MikkelBlom/SENNEP-V2/print/chassis_v1/LÆS MIG.md

# Chassis v1 — minimum rullende stel

4 housings (hjørnerne) + det her = et stel, der kan samles og rulle. Kofangere, ydre tværbjælker, LiDAR-mast og batteriplade kommer senere.
Alle filer er vendt rigtigt (printfladen på Z = 0). **Ingen support.**

| Fil | Antal | Ligger på pladen med | Mål |
|---|---|---|---|
| 4x_Rail.stl | 4 | Toppen (den lukkede side) nedad | 60 × 219 × 50 mm |
| 4x_Cross_half.stl | 4 | Toppen nedad | 199 × 34 × 40 mm |
| 4x_Key_bar.stl | 4 | En flad side | 30 × 4,2 × 4,2 mm |
| 20x_P-M8x22_bolt.stl | 20 | En af de to flade sider (liggende) | M8, du skærer gevind med snitbakke |
| 20x_P-M8_nut.stl | 20 | Flangen nedad | Ø7-hul, du tapper M8 |

**Universelle dele:** samme skinne til alle fire pladser og samme halve tværbjælke til alle (vend/drej den bare). Midtersamlingerne har en V-rille i begge dele + en løs nøglestang. Bolte og møtrikker har en indbygget flange, så der er ingen skiver.

## Indkøbt hardware
16× M3×12 + 16 M3-messingindsatser (skinnerne ind i housingernes sideflader, 4 pr. skinne).

## Samling
1. Smelt indsatserne ned i housingernes **indre** sideflader (dem, der vender mod robottens midte), 4 pr. housing.
2. Skinner på housingerne: V-ryggen i housingens rille, 4× M3×12 pr. skinne.
3. Skinnernes midtersamling: nøglestang i rillen, 4× P-M8 pr. side.
4. Tværbjælker (de to inderste, y = ±60): hver halvdel sættes i skinnens indervæg (V-ryg i rille, 2× P-M8), de to halvdele samles i midten med en nøglestang og 2× P-M8.
   Skinnerne har riller og huller i begge vægge, så samme del passer i alle hjørner — dem i ydervæggen bruges ikke.
