MikkelBlom/SENNEP-V2/docs/skelet/body_v0_front.png

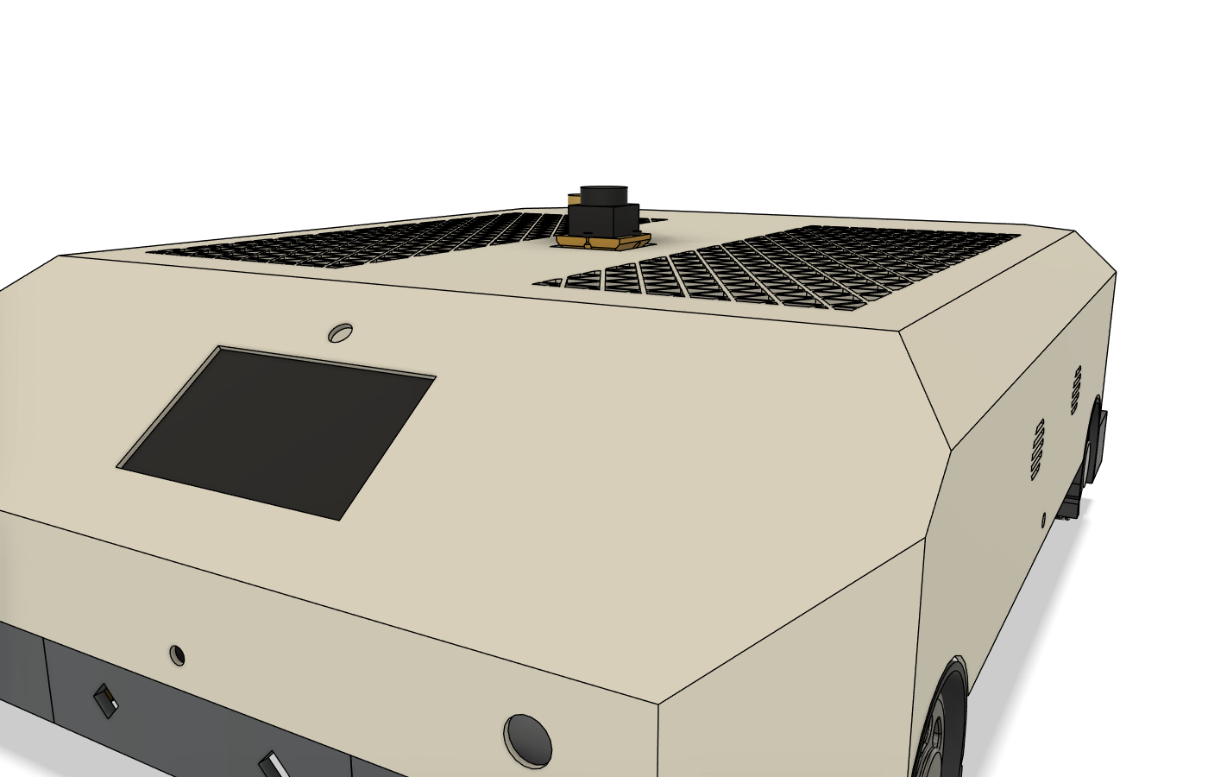
docs/skelet/body_v0_front.png
