MikkelBlom/SENNEP-V2/docs/skelet/body_v0_skraat.png

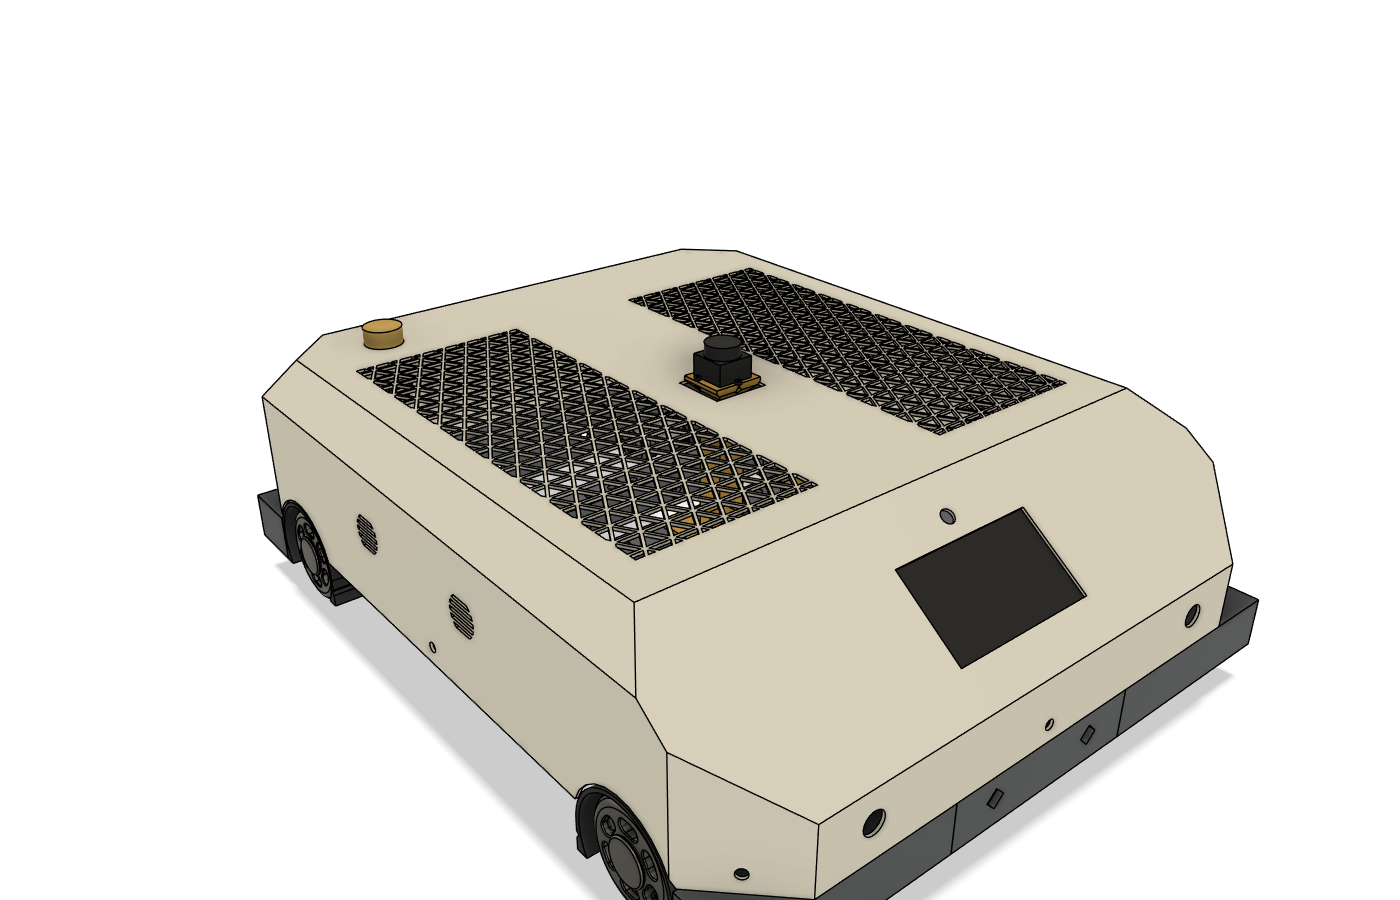
docs/skelet/body_v0_skraat.png
