MikkelBlom/SENNEP-V2/docs/skelet/pod_gennemsigtig.png

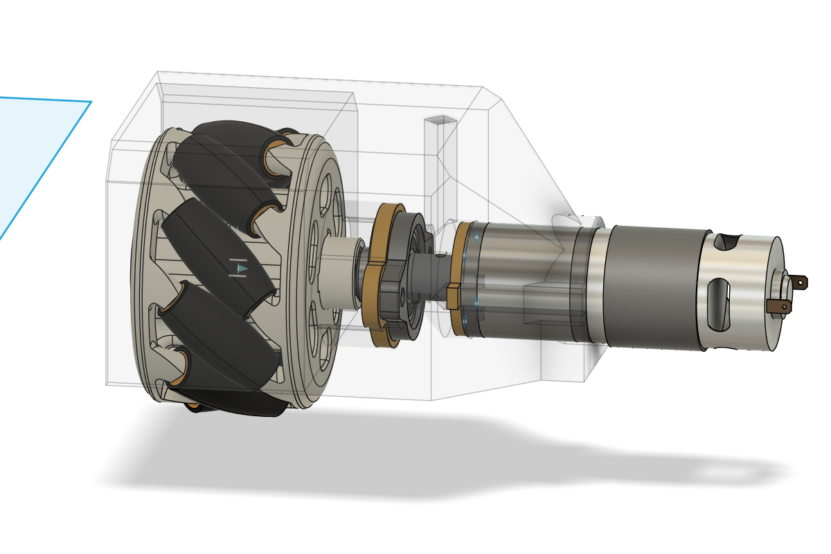
docs/skelet/pod_gennemsigtig.png
