MikkelBlom/SENNEP-V2/docs/skelet/pod_hjulside.png

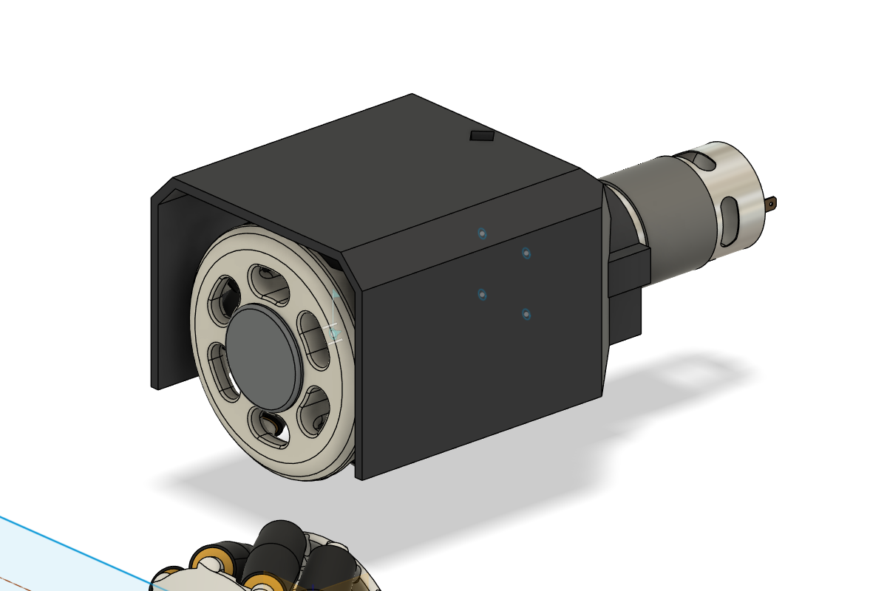
docs/skelet/pod_hjulside.png
