MikkelBlom/SENNEP-V2/docs/skelet/v1_skelet_iso.png

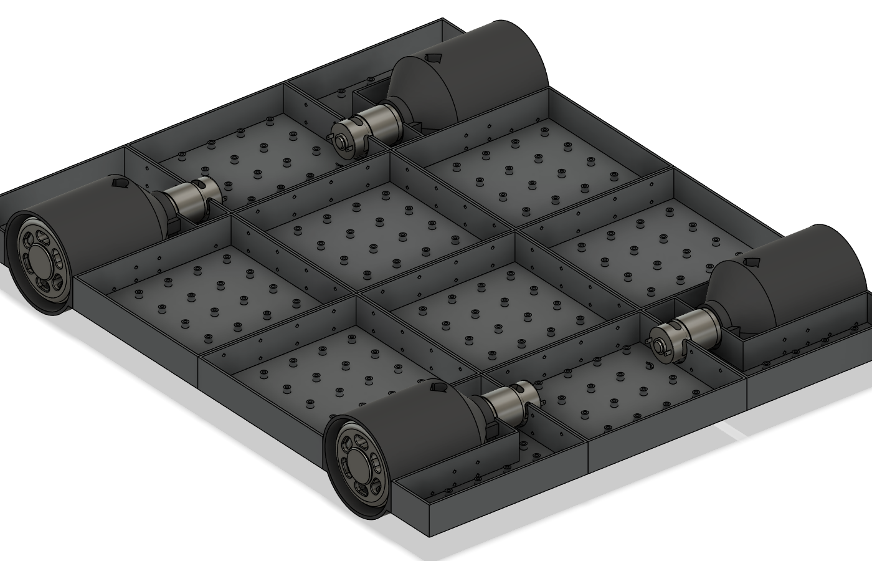
docs/skelet/v1_skelet_iso.png
