MikkelBlom/SENNEP-V2/docs/skelet/v1_skelet_top.png

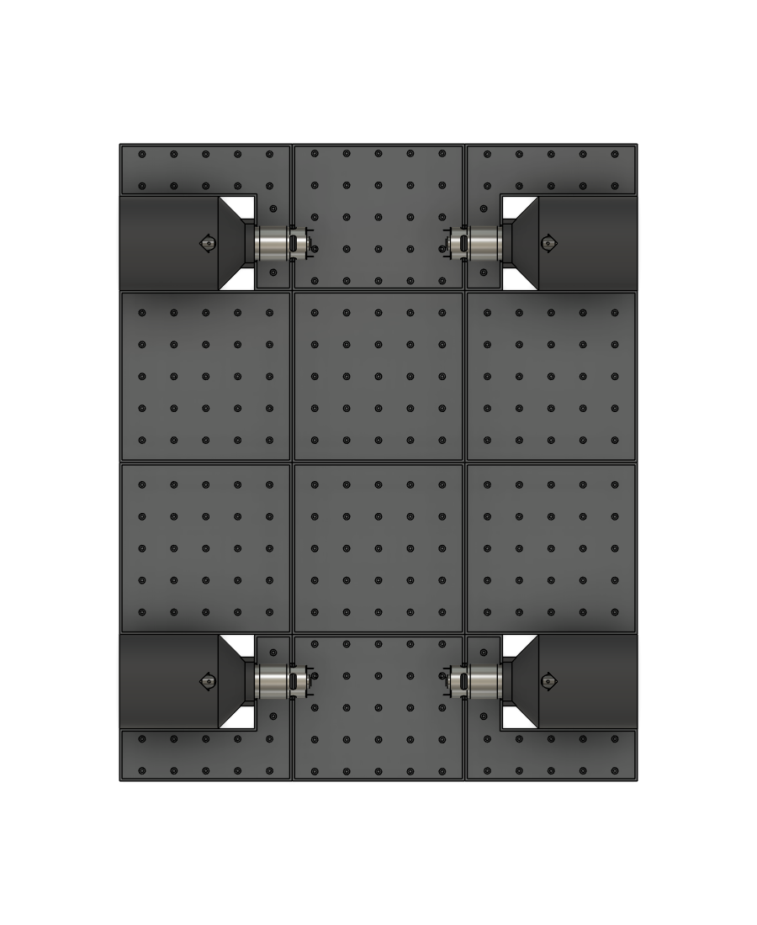
docs/skelet/v1_skelet_top.png
