MikkelBlom/SENNEP-V2/docs/skelet/v2_batteri.png

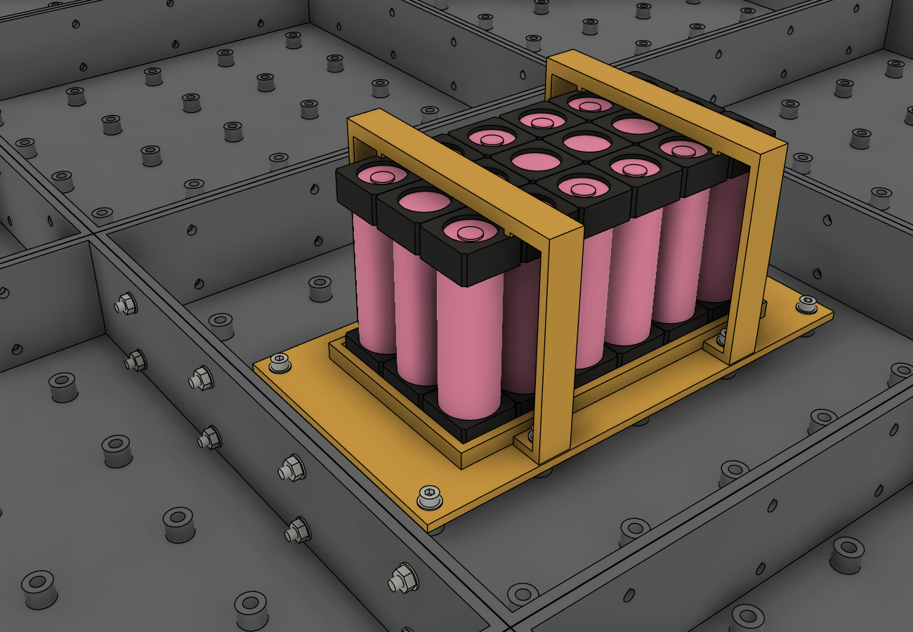
docs/skelet/v2_batteri.png
