MikkelBlom/SENNEP-V2/docs/skelet/v2_hjul_mod_gulv.png

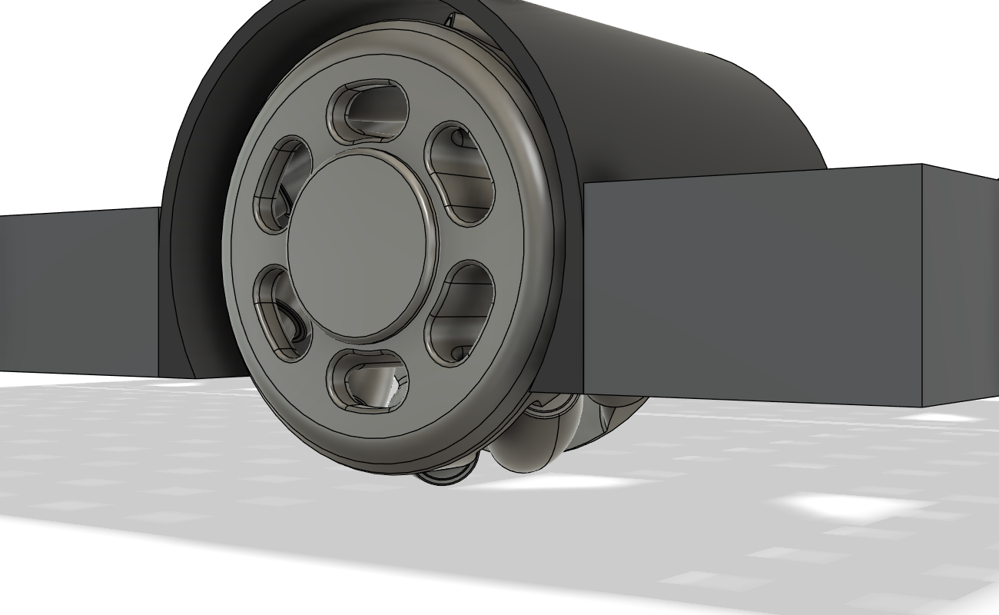
docs/skelet/v2_hjul_mod_gulv.png
