MikkelBlom/SENNEP-V2/docs/skelet/v3_diamantkanal.png

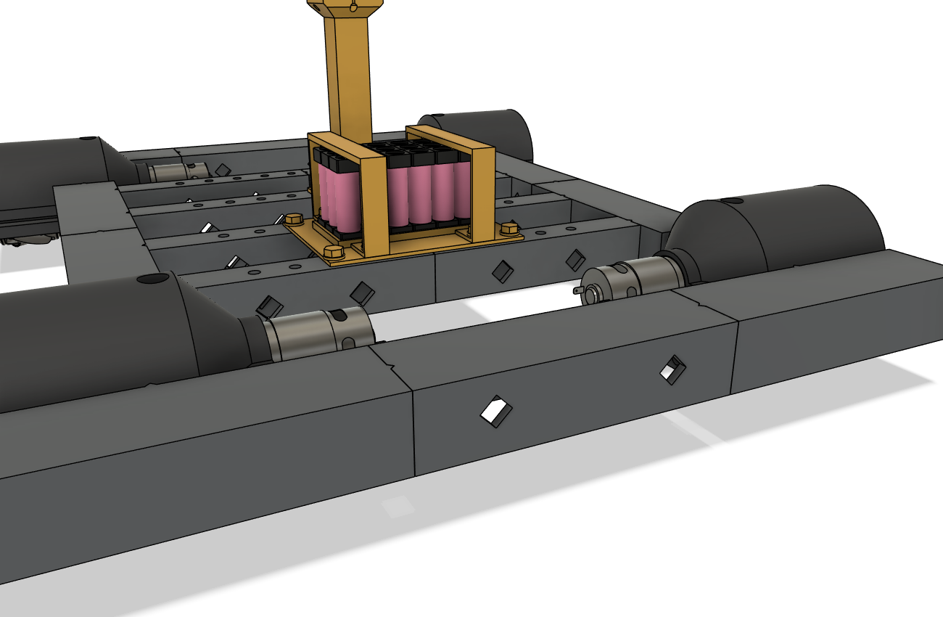
docs/skelet/v3_diamantkanal.png
