MikkelBlom/SENNEP-V2/docs/skelet/v3_kofanger_kvadrathul.png

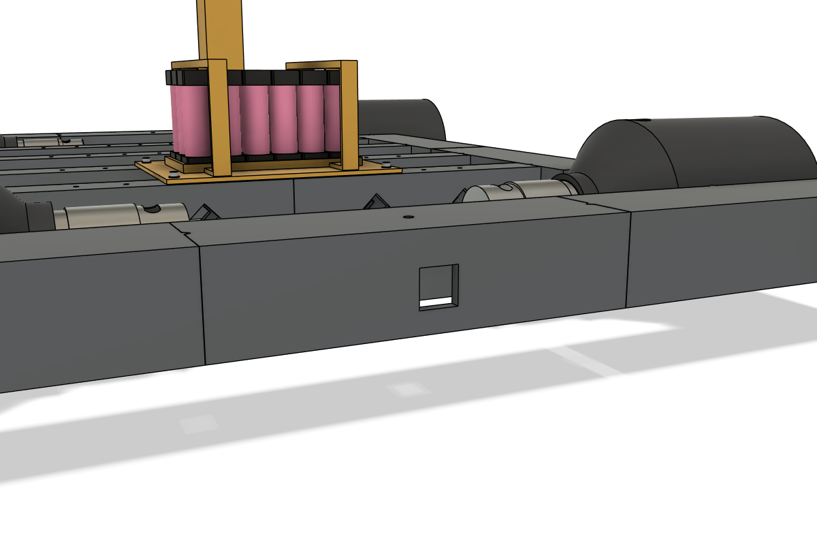
docs/skelet/v3_kofanger_kvadrathul.png
