MikkelBlom/SENNEP-V2/docs/skelet/v3_samling_nedefra.png

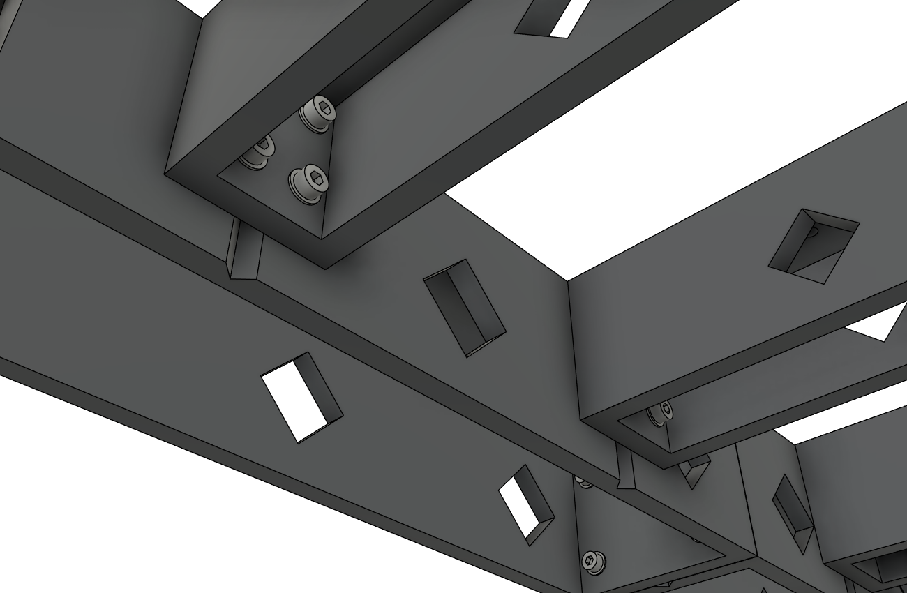
docs/skelet/v3_samling_nedefra.png
