MikkelBlom/SENNEP-V2/print/testhjul_v3.1/hjulkasse/samling_1_hardware.png

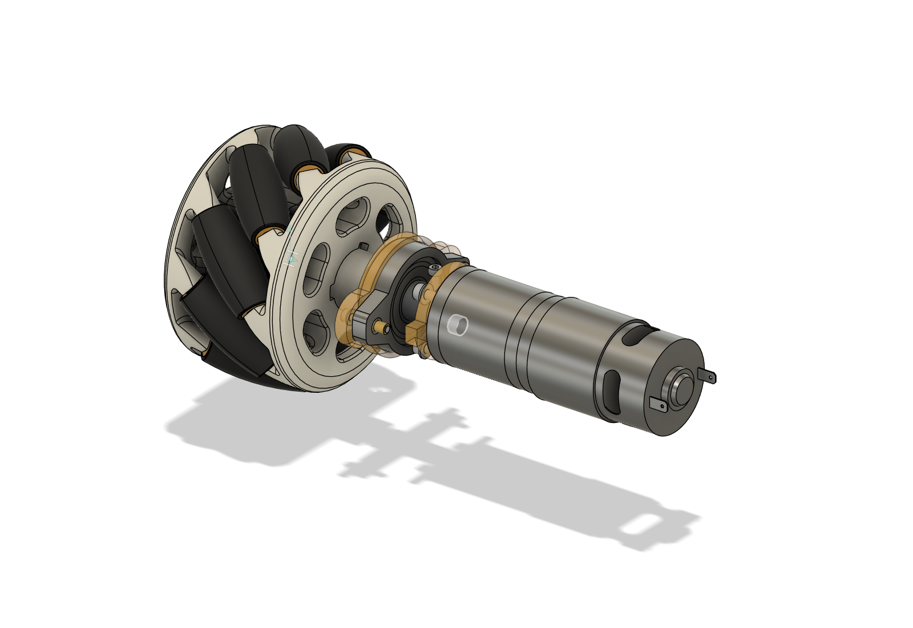
print/testhjul_v3.1/hjulkasse/samling_1_hardware.png
