MikkelBlom/SENNEP-V2/print/testhjul_v3.1/hjulkasse/samling_2_hardware_uden_hjul.png

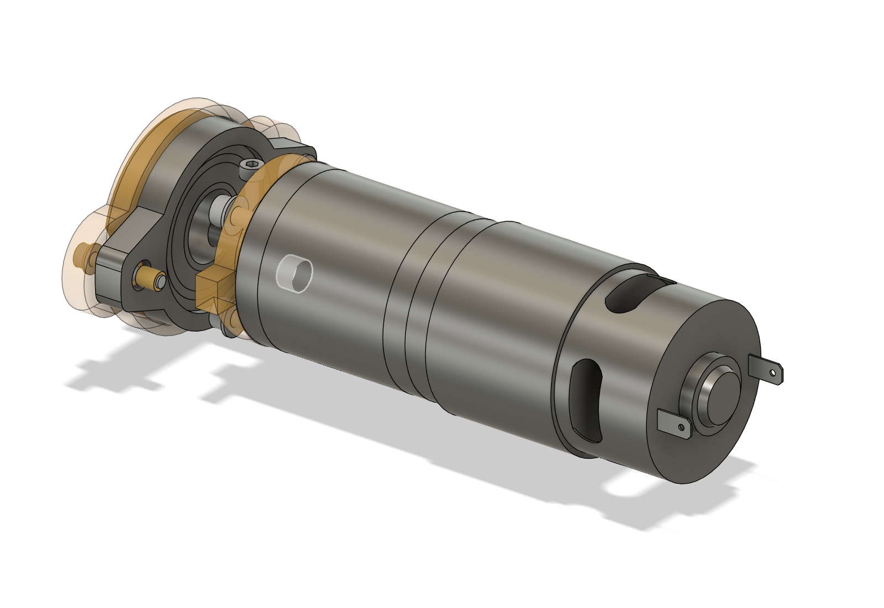
print/testhjul_v3.1/hjulkasse/samling_2_hardware_uden_hjul.png
