MikkelBlom/SENNEP-V2/components/INVENTORY.md

# Parts list — SENNEP V2

> Generated by `build_inventory.py` from `inventory.csv`. Edit the CSV, not this file.

100 lines · [Compute](#compute) · [Drivetrain](#drivetrain) · [Power](#power) · [Sensors](#sensors) · [Communication](#communication) · [UI](#ui) · [Sound](#sound) · [Lighting](#lighting) · [Control](#control) · [Connectors](#connectors) · [Cables](#cables) · [Passives](#passives) · [Mechanical](#mechanical) · [Hardware](#hardware) · [Consumables](#consumables) · [Tools](#tools)

## By source

| Source | Lines |
|---|---:|
| SENNEP V2 | 86 |
| SENNEP V1 | 3 |
| other project | 11 |

## By store (excl. shipping)

| Store | ≈ DKK |
|---|---:|
| Ardustore | 2,003 kr |
| Hobby Components | 824 kr |
| Bot'n Roll | 2,693 kr |
| AliExpress | 883 kr |
| RS / school (V1) | 2,400 kr |

## Compute

| id | Part | Qty | Source | Condition | ≈ DKK | Store | Date | Datasheet / links | Notes |
|---|---|---:|---|---|---:|---|---|---|---|
| `arduino-mega` | Arduino Mega 2560 R3 (clone) | 2 | SENNEP V2 | unknown | 490 kr | Ardustore | 2024-05-14 | [arduino-mega-2560.pdf](datasheets/arduino-mega-2560.pdf) | Main MCU for the Pi link (Nano also used) |
| `arduino-nano` | Arduino Nano clone, CH340, USB-C | 2 | SENNEP V2 | unknown | 65 kr | Hobby Components | 2025-04-18 | [arduino-nano.pdf](datasheets/arduino-nano.pdf) · [ch340.pdf](datasheets/ch340.pdf) | Low-level jobs alongside the Mega. Needs the CH340 driver on Windows |
| `nano-terminal` | Screw-terminal adapter for Arduino Nano | 2 | SENNEP V2 | unknown | 27 kr | Hobby Components | 2025-04-18 |  |  |
| `raspberry-pi-5` | Raspberry Pi 5 | 1 | SENNEP V2 | unknown | ? | unknown | 2025-05 | [raspberry-pi-5.pdf](datasheets/raspberry-pi-5.pdf) | No receipt. RAM 4 or 8 GB per Mikkel (unconfirmed: check the sticker or run free -h). At Mikkel's parents (Oct 2026) |
| `pi5-case` | Aluminium case for Pi 5 with 2 fans (Waveshare 26086) | 1 | SENNEP V2 | unknown | 70 kr | Bot'n Roll | 2025-05-01 |  |  |
| `sd-32gb` | microSDHC 32 GB Adata Class 10 | 1 | SENNEP V2 | unknown | 34 kr | Bot'n Roll | 2025-05-01 |  | Pi OS installed May 2025 (user sennep) |
| `sd-16gb` | SD card 16 GB Class 10 + adapter | 1 | SENNEP V2 | unknown | 50 kr | Ardustore | 2024-05-14 |  |  |

## Drivetrain

| id | Part | Qty | Source | Condition | ≈ DKK | Store | Date | Datasheet / links | Notes |
|---|---|---:|---|---|---:|---|---|---|---|
| `l298n` | L298N dual H-bridge module | 2 | SENNEP V2 | unknown | 80 kr | Ardustore | 2024-05-14 | [l298n.pdf](datasheets/l298n.pdf) | Max ~2 A/channel and ~2 V drop. To be replaced by h-bridge-43a |
| `h-bridge-43a` | High-power H-bridge motor driver (probably BTS7960, 43 A) | 5 | SENNEP V2 | unknown | 182 kr | AliExpress | 2025-12 | [bts7960.pdf](datasheets/bts7960.pdf) | Item name truncated in the order mail, so the chip is not confirmed. 4 in use + 1 spare |
| `motor-rs834` | RS PRO 834-7641 gear motor 12 V, 49:1 (975D series) | 4 | SENNEP V1 | unknown | 2,400 kr | RS / school (V1) | 2020-2023 | [rs-pro-834-7641-motor.pdf](datasheets/rs-pro-834-7641-motor.pdf) | Approximate price for all 4. 8 mm shaft, 143 rpm, 41 W. Radial load < 5 kgf -> pillow blocks carry the weight |

## Power

| id | Part | Qty | Source | Condition | ≈ DKK | Store | Date | Datasheet / links | Notes |
|---|---|---:|---|---|---:|---|---|---|---|
| `18650-35e` | Samsung INR18650-35E Li-ion 3400 mAh | 20 | SENNEP V2 | unknown | 880 kr | Bot'n Roll | 2025-05-01 | [samsung-inr18650-35e.pdf](datasheets/samsung-inr18650-35e.pdf) | Planned 3S6P (10.8 V nom / 12.6 V full, ~20 Ah). Only clicked into holders, no connections at all (Oct 2026). Plan: docs/electronics/BATTERY_PLAN.md |
| `18650-holder` | 18650 holder 1×2 with spacer | 20 | SENNEP V2 | unknown | 45 kr | Bot'n Roll | 2025-05-01 |  | Click-together plastic, no metal contacts |
| `nickel-strip` | Pure nickel strip 0.15 mm for integrated 18650 holders, 1P + 2P (2P = ladder ~27 mm wide), 19 mm spacing | 1 | SENNEP V2 | unknown | ? | AliExpress | 2025-05 |  | Rolls, length unknown. 2P = two rails joined by rungs, meant to span two rows (strips A and D), 1P for B and C. Strip pitch 19 mm vs holder pitch (to measure). See docs/electronics/BATTERY_PLAN.md §4 |
| `bms-3s` | 3S 40 A BMS with balancing (HW-288 per product photo) | 2 | SENNEP V2 | unknown | 73 kr | Bot'n Roll | 2025-05-01 | [web](https://www.botnroll.com/en/bms/4974-li-ion-18650-bms-charger-pcb-prot-board-3s-11-1v-12-6v-40a-with-balance.html) | Listing: 40 A continuous (less without cooling), start current < 80 A, charge 12.6–13.6 V up to 10 A, auto recovery, 60 × 41 × 3.4 mm. Taps 0 / 4.2 / 8.4 / 12.6 V = B− / B1 / B2 / B+. Mikkel thinks 2 or 3 bought |
| `charger-3s` | 3S Li-ion charger 12.6 V 2 A (EU plug) | 1 | SENNEP V2 | unknown | 89 kr | Bot'n Roll | 2025-05-01 |  |  |
| `buck-5a` | DC-DC step-down 5 A | 2 | SENNEP V2 | unknown | 61 kr | Hobby Components | 2025-04-18 |  | Meant for the Pi 5 (5 V / 5 A) |
| `lm2596-module` | LM2596 step-down module with voltmeter | 3 | SENNEP V2 | unknown | 58 kr | Hobby Components | 2025-04-18 | [lm2596.pdf](datasheets/lm2596.pdf) | Max 3 A |
| `lm2596t-12` | LM2596T-12 regulator (TO-220, fixed 12 V) | 3 | SENNEP V2 | unknown | 24 kr | Ardustore | 2024-05-14 | [lm2596.pdf](datasheets/lm2596.pdf) |  |
| `l7805` | L7805 5 V linear regulator (TO-220) | 10 | SENNEP V2 | unknown | 20 kr | Ardustore | 2024-05-14 | [l7805.pdf](datasheets/l7805.pdf) | The datasheet is TI's µA7800 (same pinout/function as ST L7805) |
| `ld1117-33` | LD1117V33 3.3 V linear regulator (TO-220) | 3 | SENNEP V2 | unknown | 24 kr | Ardustore | 2024-05-14 | [ld1117-3v3.pdf](datasheets/ld1117-3v3.pdf) | Max 800 mA. Can supply the esp-01 |
| `breadboard-psu` | Breadboard power supply (MB102 type) | 2 | SENNEP V2 | unknown | 40 kr | Ardustore | 2024-05-14 | [ams1117-breadboard-psu.pdf](datasheets/ams1117-breadboard-psu.pdf) | 5 V + 3.3 V for a breadboard |
| `irfz44n` | IRFZ44N N-MOSFET (TO-220) | 5 | SENNEP V2 | unknown | 30 kr | Ardustore | 2024-05-14 | [irfz44n.pdf](datasheets/irfz44n.pdf) | Not logic-level: needs ~10 V gate for full conduction |
| `mosfet-55v` | N-MOSFET 55 V 41 A (probably IRFZ44N) | 3 | SENNEP V2 | unknown | 22 kr | Bot'n Roll | 2025-05-01 | [irfz44n.pdf](datasheets/irfz44n.pdf) |  |
| `relay-40a` | Car relay 12 V 40 A, 5-pin | 1 | SENNEP V2 | unknown | 8 kr | AliExpress | 2025-12 |  | The E-stop drives the relay instead of breaking main power itself |
| `fuse-holder` | Fuse holder 5×20 mm with cap | 10 | SENNEP V2 | unknown | 22 kr | Bot'n Roll | 2025-05-01 |  | For 5×20 glass fuses (small branches: logic, drivers). Not for the 30 A main fuse |
| `blade-fuses` | Car blade fuses, 180-piece assortment | 1 | SENNEP V2 | unknown | 28 kr | AliExpress | 2025-12 |  | No blade holders listed: the 30 A main fuse needs an inline blade holder (shopping list) |
| `lipo-zippy-1000` | Zippy Compact 35C LiPo 1000 mAh 3S 11.1 V (XT60) | 1 | SENNEP V1 | used | ? |  |  |  | No BMS. Fried V1's Mega: only use with a fuse < 10 cm from the XT60 and a LiPo alarm (added in consolidation 2026-10-12, not counted yet) |
| `adapter-12v` | 12 V power adapter | 1 | other project | unknown | ? |  |  |  | Rating unknown (≥ 3 A needed for bench logic) (added in consolidation 2026-10-12, not counted yet) |

## Sensors

| id | Part | Qty | Source | Condition | ≈ DKK | Store | Date | Datasheet / links | Notes |
|---|---|---:|---|---|---:|---|---|---|---|
| `vl53l0x` | VL53L0X ToF distance sensor (laser) | 8 | SENNEP V2 | unknown | 219 kr | Hobby Components | 2025-04-18 | [vl53l0x.pdf](datasheets/vl53l0x.pdf) | Same I²C address (0x29) -> used via tca9548a. 8 around the robot |
| `e18-d80nk` | E18-D80NK IR proximity sensor (adjustable) | 4 | SENNEP V2 | unknown | 127 kr | Hobby Components | 2025-04-18 |  | Edge detectors in the corners. No official datasheet exists |
| `hc-sr04` | HC-SR04 ultrasonic range finder | 4 | SENNEP V2 | unknown | 80 kr | Ardustore | 2024-05-14 | [hc-sr04.pdf](datasheets/hc-sr04.pdf) | 5 V logic |
| `mpu-6050` | MPU-6050 accelerometer + gyro | 1 | SENNEP V2 | unknown | 37 kr | Bot'n Roll | 2025-05-01 | [mpu-6050.pdf](datasheets/mpu-6050.pdf) · [mpu-6050-register-map.pdf](datasheets/mpu-6050-register-map.pdf) | I²C 0x68 |
| `qmc5883l` | GY-271 magnetometer (QMC5883L) | 1 | SENNEP V2 | unknown | 19 kr | AliExpress | 2025-12 | [qmc5883l.pdf](datasheets/qmc5883l.pdf) | I²C 0x0D (not the HMC5883L's 0x1E) |
| `neo-6m` | GY-NEO6MV2 GPS module | 1 | SENNEP V2 | unknown | 17 kr | AliExpress | 2025-12 | [neo-6m.pdf](datasheets/neo-6m.pdf) | UART 9600 baud. To be included (decided) |
| `ina219` | INA219 current/voltage monitor | 1 | SENNEP V2 | unknown | 15 kr | AliExpress | 2025-12 | [ina219.pdf](datasheets/ina219.pdf) | Battery monitoring. Max 26 V |
| `tsl2561` | TSL2561 light sensor | 1 | SENNEP V2 | unknown | 36 kr | Hobby Components | 2025-04-18 | [tsl2561.pdf](datasheets/tsl2561.pdf) |  |
| `ds3231` | DS3231 RTC module (ZS-042) | 1 | SENNEP V2 | unknown | 45 kr | Ardustore | 2024-05-14 | [ds3231.pdf](datasheets/ds3231.pdf) | The ZS-042 has a charging circuit for CR2032. Remove the diode/resistor with a non-rechargeable cell |
| `mic-module` | Microphone module with adjustment | 5 | SENNEP V2 | unknown | 75 kr | Ardustore | 2024-05-14 | [lm393-microphone-module.pdf](datasheets/lm393-microphone-module.pdf) | Digital output via comparator + analog output. Level only, no direction |
| `vs1838b` | VS1838B IR receiver 38 kHz | 10 | SENNEP V2 | unknown | 30 kr | Bot'n Roll | 2025-05-01 | [vs1838b-ir-receiver.pdf](datasheets/vs1838b-ir-receiver.pdf) | Dock beacon (receiver) |
| `door-switch` | Magnetic door switch MC-38 (NC) | 1 | SENNEP V2 | unknown | 25 kr | Ardustore | 2024-05-14 |  |  |
| `lidar-ld19` | LDROBOT LD19 / STL-19P LiDAR (sold as youyeetoo FHL-LD19) | 1 | SENNEP V2 | unknown | ? | unknown | 2025-05 | [ld19-stl-19p-datasheet.pdf](datasheets/ld19-stl-19p-datasheet.pdf) · [ld19-development-manual.pdf](datasheets/ld19-development-manual.pdf) | No receipt. UART 230400 baud, 3.3 V logic. Test app in Lidar Test Enviornment/ |
| `pi-ai-camera` | Raspberry Pi AI Camera (IMX500, 12 MP) | 1 | SENNEP V2 | unknown | 633 kr | Bot'n Roll | 2025-05-01 | [pi-ai-camera.pdf](datasheets/pi-ai-camera.pdf) · [web](https://www.raspberrypi.com/documentation/accessories/ai-camera.html) |  |

## Communication

| id | Part | Qty | Source | Condition | ≈ DKK | Store | Date | Datasheet / links | Notes |
|---|---|---:|---|---|---:|---|---|---|---|
| `nrf24l01` | NRF24L01 2.4 GHz radio module | 3 | SENNEP V2 | unknown | 60 kr | Ardustore | 2024-05-14 | [nrf24l01.pdf](datasheets/nrf24l01.pdf) | 3.3 V supply (5 V-tolerant pins). Manual control / RF joystick |
| `esp-01` | ESP8266 ESP-01 WiFi module | 1 | SENNEP V2 | unknown | 25 kr | Ardustore | 2024-05-14 | [esp8266ex.pdf](datasheets/esp8266ex.pdf) · [esp8266-at-commands.pdf](datasheets/esp8266-at-commands.pdf) · [notes](esp-01/README.md) | Probably never used. 3.3 V ONLY: do not use the Mega's 3V3 pin. Pinout, diagram and code in esp-01/ |
| `tca9548a` | TCA9548A I²C multiplexer (8 channels) | 5 | SENNEP V2 | unknown | 35 kr | AliExpress | 2025-12 | [tca9548a.pdf](datasheets/tca9548a.pdf) | Solves all 8 VL53L0X sharing one address. I²C 0x70-0x77 |
| `level-converter` | 4-channel logic level converter 3.3 V <-> 5 V | 1 | SENNEP V2 | unknown | 11 kr | AliExpress | 2025-12 | [bss138-level-converter.pdf](datasheets/bss138-level-converter.pdf) | Bidirectional (BSS138). Fine for I²C and UART |
| `cp2102` | CP2102 USB-UART adapter (came with the LiDAR kit) | 1 | SENNEP V2 | unknown | ? |  |  |  | Connects the LiDAR to the Pi 5 over USB (added in consolidation 2026-10-12, not counted yet) |

## UI

| id | Part | Qty | Source | Condition | ≈ DKK | Store | Date | Datasheet / links | Notes |
|---|---|---:|---|---|---:|---|---|---|---|
| `screen-7` | 7" HDMI LCD (C) 1024×600 IPS, touch (Waveshare) | 1 | SENNEP V2 | unknown | 484 kr | Bot'n Roll | 2025-05-01 | [web](https://www.waveshare.com/wiki/7inch_HDMI_LCD_(C)) | Mounting holes did not match in the laser-cut test |
| `lcd-20x4` | 20×4 LCD, white | 2 | SENNEP V2 | unknown | 160 kr | Ardustore | 2024-05-14 | [hd44780-lcd.pdf](datasheets/hd44780-lcd.pdf) |  |
| `lcd-16x2` | 16×2 LCD, white | 4 | SENNEP V2 | unknown | 240 kr | Ardustore | 2024-05-14 | [hd44780-lcd.pdf](datasheets/hd44780-lcd.pdf) |  |
| `i2c-lcd-adapter` | I²C adapter for LCD (backpack) | 6 | SENNEP V2 | unknown | 120 kr | Ardustore | 2024-05-14 | [pcf8574-i2c-lcd-adapter.pdf](datasheets/pcf8574-i2c-lcd-adapter.pdf) | I²C 0x27 (PCF8574) or 0x3F (PCF8574A) |
| `keypad-3x4` | Membrane keypad 3×4 | 1 | SENNEP V2 | unknown | 15 kr | Ardustore | 2024-05-14 |  |  |
| `voltmeter-display` | 0.28" voltmeter display 0–30 V | 1 | SENNEP V2 | unknown | 9 kr | AliExpress | 2025-12 |  |  |

## Sound

| id | Part | Qty | Source | Condition | ≈ DKK | Store | Date | Datasheet / links | Notes |
|---|---|---:|---|---|---:|---|---|---|---|
| `dfplayer` | DFPlayer Mini MP3 player | 2 | SENNEP V2 | unknown | 60 kr | Ardustore | 2024-05-14 | [dfplayer-mini.pdf](datasheets/dfplayer-mini.pdf) | UART 9600 baud. Use 1 kΩ in series on RX with 5 V logic |
| `dfplayer-2` | DFPlayer Mini MP3 player | 1 | SENNEP V2 | unknown | 74 kr | Bot'n Roll | 2025-05-01 | [dfplayer-mini.pdf](datasheets/dfplayer-mini.pdf) | 3 in total together with dfplayer |
| `speaker-1w` | Speaker 1 W 8 Ω with adhesive gasket | 8 | SENNEP V2 | unknown | 48 kr | Hobby Components | 2025-04-18 |  |  |
| `pam8403` | PAM8403 mini amplifier 2×3 W (5 pcs) | 5 | SENNEP V2 | unknown | 12 kr | AliExpress | 2025-12 | [pam8403.pdf](datasheets/pam8403.pdf) | 5 V supply |

## Lighting

| id | Part | Qty | Source | Condition | ≈ DKK | Store | Date | Datasheet / links | Notes |
|---|---|---:|---|---|---:|---|---|---|---|
| `ws2812b` | WS2812B LED strip 5 m, 30 LED/m | 1 | SENNEP V2 | unknown | 52 kr | AliExpress | 2025-12 | [ws2812b.pdf](datasheets/ws2812b.pdf) | 150 LEDs -> up to ~9 A at full white. 5 V |
| `led-3w` | 3 W LED module | 4 | SENNEP V2 | unknown | 88 kr | Bot'n Roll | 2025-05-01 |  | Head-lights. Need current limiting |
| `ir-led-940` | IR LED 940 nm | 10 | SENNEP V2 | unknown | 45 kr | Bot'n Roll | 2025-05-01 |  | Dock beacon (transmitter) |

## Control

| id | Part | Qty | Source | Condition | ≈ DKK | Store | Date | Datasheet / links | Notes |
|---|---|---:|---|---|---:|---|---|---|---|
| `joystick-ky023` | KY-023 analog joystick (XY + button) | 4 | SENNEP V2 | unknown | 60 kr | Ardustore | 2024-05-14 |  |  |
| `potentiometer` | Potentiometer, horizontal | 5 | SENNEP V2 | unknown | 10 kr | Ardustore | 2024-05-14 |  |  |

## Connectors

| id | Part | Qty | Source | Condition | ≈ DKK | Store | Date | Datasheet / links | Notes |
|---|---|---:|---|---|---:|---|---|---|---|
| `xt60` | XT60 male/female pair | 2 | SENNEP V2 | unknown | 22 kr | Bot'n Roll | 2025-05-01 |  |  |
| `estop-40mm` | Emergency stop 40 mm | 1 | SENNEP V2 | unknown | 13 kr | Hobby Components | 2025-04-18 |  |  |
| `key-switch` | Key switch S1203 12 mm on/off | 1 | SENNEP V2 | unknown | 18 kr | Ardustore | 2024-05-14 |  |  |
| `toggle-mts103` | Toggle switch MTS-103 on-off-on 6 A | 1 | SENNEP V2 | unknown | 7 kr | Ardustore | 2024-05-14 |  |  |
| `pushbutton-red` | Push button PBS-110 red | 1 | SENNEP V2 | unknown | 5 kr | Ardustore | 2024-05-14 |  |  |
| `screw-terminal-3p` | Screw terminal 3-pole 5.0 mm, blue (10 per pack) | 3 | SENNEP V2 | unknown | 28 kr | Hobby Components | 2025-04-18 |  | 3 packs = 30 pcs |
| `jst-ph-2` | JST PH 2.0 mm connector, 2-pole | 5 | SENNEP V2 | unknown | 7 kr | Bot'n Roll | 2025-05-01 |  |  |
| `jst-ph-3` | JST PH 2.0 mm connector, 3-pole | 5 | SENNEP V2 | unknown | 7 kr | Bot'n Roll | 2025-05-01 |  |  |
| `9v-clip` | DC plug for 9 V battery clip | 2 | SENNEP V2 | unknown | 6 kr | Hobby Components | 2025-04-18 |  |  |

## Cables

| id | Part | Qty | Source | Condition | ≈ DKK | Store | Date | Datasheet / links | Notes |
|---|---|---:|---|---|---:|---|---|---|---|
| `cable-10awg` | Silicone cable 10 AWG, 2 m | 3 | SENNEP V2 | unknown | 115 kr | AliExpress | 2025-12 |  |  |
| `cable-16awg` | Cable 16 AWG, 10 m | 1 | SENNEP V2 | unknown | 60 kr | AliExpress | 2025-12 |  |  |
| `cable-22awg` | Cable 22 AWG, 50 m (5×10 m) | 1 | SENNEP V2 | unknown | 74 kr | AliExpress | 2025-12 |  |  |
| `alligator-leads` | Alligator clip leads, 10 pcs | 1 | SENNEP V2 | unknown | 29 kr | Bot'n Roll | 2025-05-01 |  |  |

## Passives

| id | Part | Qty | Source | Condition | ≈ DKK | Store | Date | Datasheet / links | Notes |
|---|---|---:|---|---|---:|---|---|---|---|
| `ceramic-kit` | Ceramic capacitors, 300 pcs (2 pF–0.1 µF) | 1 | SENNEP V2 | unknown | 17 kr | Hobby Components | 2025-04-18 |  |  |
| `electrolytic-kit` | Electrolytic capacitors, 120 pcs | 1 | SENNEP V2 | unknown | 27 kr | Hobby Components | 2025-04-18 |  |  |
| `smd-diodes` | SMD diodes, 70 pcs | 1 | SENNEP V2 | unknown | 13 kr | Hobby Components | 2025-04-18 |  |  |
| `resistor-kit` | Resistor assortment kit | 1 | other project | unknown | ? |  |  |  | Many values (added in consolidation 2026-10-12, not counted yet) |

## Mechanical

| id | Part | Qty | Source | Condition | ≈ DKK | Store | Date | Datasheet / links | Notes |
|---|---|---:|---|---|---:|---|---|---|---|
| `kfl003` | KFL003 pillow block bearing, 17 mm (2 per pack) | 6 | SENNEP V2 | unknown | 131 kr | AliExpress | 2025-12 |  | 3 packs = 6 bearings. Self-aligning |
| `heatsink-to220` | Aluminium heatsink TO-220 | 5 | SENNEP V2 | unknown | 25 kr | Ardustore | 2024-05-14 |  |  |
| `fan-40mm` | Fan 40×40 mm brushless DC | 4 | SENNEP V2 | unknown | 23 kr | Hobby Components | 2025-04-18 |  | Voltage not stated on the invoice |
| `protoboard-12x18` | Protoboard double-sided 12×18 cm | 4 | SENNEP V2 | unknown | 56 kr | Hobby Components | 2025-04-18 |  |  |
| `solderable-breadboard` | Solderable breadboard, 400 holes | 1 | SENNEP V2 | unknown | 10 kr | AliExpress | 2025-12 |  |  |
| `hex-screw-assortment` | Stainless hex socket screws, 290-piece assortment | 1 | SENNEP V2 | unknown | 64 kr | AliExpress | 2025-12 |  | Sizes unknown |
| `insert-m3` | Brass threaded inserts M3, 100 pcs | 1 | SENNEP V2 | unknown | 42 kr | AliExpress | 2025-12 |  | Melted in with the soldering iron |

## Hardware

| id | Part | Qty | Source | Condition | ≈ DKK | Store | Date | Datasheet / links | Notes |
|---|---|---:|---|---|---:|---|---|---|---|
| `screw-kit-m2-m4` | Old M2–M4 screw kit (M3×12/×19 ×20 each, M4×12 ×20, M4×25 ×10, nuts, washers) | 1 | other project | unknown | ? |  |  |  | (added in consolidation 2026-10-12, not counted yet) |

## Consumables

| id | Part | Qty | Source | Condition | ≈ DKK | Store | Date | Datasheet / links | Notes |
|---|---|---:|---|---|---:|---|---|---|---|
| `petg` | PETG filament (kg) | 15 | SENNEP V2 | unknown | ? | unknown |  |  | 15 kg was the stock in 2025 |
| `solder` | Solder 1.0 mm, 100 g | 1 | SENNEP V2 | unknown | 95 kr | Ardustore | 2024-05-14 |  |  |
| `thermal-paste` | Silicone thermal paste, 30 g | 1 | SENNEP V2 | unknown | 75 kr | Ardustore | 2024-05-14 |  |  |
| `filament-tpu` | TPU filament | 1 | other project | unknown | ? |  |  |  | Amount left unknown (added in consolidation 2026-10-12, not counted yet) |

## Tools

| id | Part | Qty | Source | Condition | ≈ DKK | Store | Date | Datasheet / links | Notes |
|---|---|---:|---|---|---:|---|---|---|---|
| `side-cutters` | Side cutters 125 mm | 1 | SENNEP V2 | unknown | 45 kr | Ardustore | 2024-05-14 |  |  |
| `tap-die-set` | Tap & die set M3–M12 | 1 | other project | unknown | ? |  |  |  | Used to cut the printed M8 bolts (added in consolidation 2026-10-12, not counted yet) |
| `soldering-station` | Puctec ZD-99 soldering station 48 W | 1 | other project | unknown | ? |  |  |  | Too weak for cells; OK for BMS pads and nickel tabs ≥ 10 mm from cells (added in consolidation 2026-10-12, not counted yet) |
| `multimeter-fluke83` | Fluke 83 multimeter | 1 | other project | ok | ? |  |  |  | (added in consolidation 2026-10-12, not counted yet) |
| `printer-x1c` | Bambu Lab X1C 3D printer | 1 | other project | ok | ? |  |  |  | 220 mm usable plate (added in consolidation 2026-10-12, not counted yet) |
| `calipers` | Calipers | 1 | other project | unknown | ? |  |  |  | (added in consolidation 2026-10-12, not counted yet) |
| `screwdrivers` | Screwdriver set (≤ Ø16 × 150 mm) | 1 | other project | unknown | ? |  |  |  | Sizes set the housing tool channels (added in consolidation 2026-10-12, not counted yet) |
| `lipo-charger-b3` | HobbyKing B3 AC compact LiPo charger | 1 | SENNEP V1 | unknown | ? |  |  |  | (added in consolidation 2026-10-12, not counted yet) |
| `breadboards` | Breadboards + Dupont jumpers | 1 | other project | unknown | ? |  |  |  | Quantity unknown (added in consolidation 2026-10-12, not counted yet) |
