MikkelBlom/SENNEP-V2/components/inventory.csv

id | name | category | qty | source | condition | counted | line_price | currency | dkk | store | date | chip | datasheets | links | notes
arduino-mega | Arduino Mega 2560 R3 (clone) | Compute | 2 | SENNEP V2 | unknown |  | 490 | DKK | 490.00 | Ardustore | 2024-05-14 | ATmega2560 | arduino-mega-2560.pdf |  | Main MCU for the Pi link (Nano also used)
arduino-nano | Arduino Nano clone, CH340, USB-C | Compute | 2 | SENNEP V2 | unknown |  | 7.48 | GBP | 64.85 | Hobby Components | 2025-04-18 | ATmega328P + CH340 | arduino-nano.pdf ch340.pdf |  | Low-level jobs alongside the Mega. Needs the CH340 driver on Windows
nano-terminal | Screw-terminal adapter for Arduino Nano | Compute | 2 | SENNEP V2 | unknown |  | 3.15 | GBP | 27.31 | Hobby Components | 2025-04-18
raspberry-pi-5 | Raspberry Pi 5 | Compute | 1 | SENNEP V2 | unknown |  |  |  |  | unknown | 2025-05 | BCM2712 | raspberry-pi-5.pdf |  | No receipt. RAM 4 or 8 GB per Mikkel (unconfirmed: check the sticker or run free -h). At Mikkel's parents (Oct 2026)
pi5-case | Aluminium case for Pi 5 with 2 fans (Waveshare 26086) | Compute | 1 | SENNEP V2 | unknown |  | 9.40 | EUR | 70.12 | Bot'n Roll | 2025-05-01
sd-32gb | microSDHC 32 GB Adata Class 10 | Compute | 1 | SENNEP V2 | unknown |  | 4.50 | EUR | 33.57 | Bot'n Roll | 2025-05-01 |  |  |  | Pi OS installed May 2025 (user sennep)
sd-16gb | SD card 16 GB Class 10 + adapter | Compute | 1 | SENNEP V2 | unknown |  | 50 | DKK | 50.00 | Ardustore | 2024-05-14
l298n | L298N dual H-bridge module | Drivetrain | 2 | SENNEP V2 | unknown |  | 80 | DKK | 80.00 | Ardustore | 2024-05-14 | L298N | l298n.pdf |  | Max ~2 A/channel and ~2 V drop. To be replaced by h-bridge-43a
h-bridge-43a | High-power H-bridge motor driver (probably BTS7960, 43 A) | Drivetrain | 5 | SENNEP V2 | unknown |  | 182.25 | DKK | 182.25 | AliExpress | 2025-12 | BTS7960 (assumed) | bts7960.pdf |  | Item name truncated in the order mail, so the chip is not confirmed. 4 in use + 1 spare
motor-rs834 | RS PRO 834-7641 gear motor 12 V, 49:1 (975D series) | Drivetrain | 4 | SENNEP V1 | unknown |  | 2400 | DKK | 2400.00 | RS / school (V1) | 2020-2023 |  | rs-pro-834-7641-motor.pdf |  | Approximate price for all 4. 8 mm shaft, 143 rpm, 41 W. Radial load < 5 kgf -> pillow blocks carry the weight
kfl003 | KFL003 pillow block bearing, 17 mm (2 per pack) | Mechanical | 6 | SENNEP V2 | unknown |  | 130.91 | DKK | 130.91 | AliExpress | 2025-12 |  |  |  | 3 packs = 6 bearings. Self-aligning
18650-35e | Samsung INR18650-35E Li-ion 3400 mAh | Power | 20 | SENNEP V2 | unknown |  | 118.00 | EUR | 880.28 | Bot'n Roll | 2025-05-01 |  | samsung-inr18650-35e.pdf |  | Planned 3S6P (10.8 V nom / 12.6 V full, ~20 Ah). Only clicked into holders, no connections at all (Oct 2026). Plan: docs/electronics/BATTERY_PLAN.md
18650-holder | 18650 holder 1×2 with spacer | Power | 20 | SENNEP V2 | unknown |  | 6.00 | EUR | 44.76 | Bot'n Roll | 2025-05-01 |  |  |  | Click-together plastic, no metal contacts
nickel-strip | Pure nickel strip 0.15 mm for integrated 18650 holders, 1P + 2P (2P = ladder ~27 mm wide), 19 mm spacing | Power | 1 | SENNEP V2 | unknown |  |  |  |  | AliExpress | 2025-05 |  |  |  | Rolls, length unknown. 2P = two rails joined by rungs, meant to span two rows (strips A and D), 1P for B and C. Strip pitch 19 mm vs holder pitch (to measure). See docs/electronics/BATTERY_PLAN.md §4
bms-3s | 3S 40 A BMS with balancing (HW-288 per product photo) | Power | 2 | SENNEP V2 | unknown |  | 9.80 | EUR | 73.11 | Bot'n Roll | 2025-05-01 | HW-288 (unverified) |  | https://www.botnroll.com/en/bms/4974-li-ion-18650-bms-charger-pcb-prot-board-3s-11-1v-12-6v-40a-with-balance.html | Listing: 40 A continuous (less without cooling), start current < 80 A, charge 12.6–13.6 V up to 10 A, auto recovery, 60 × 41 × 3.4 mm. Taps 0 / 4.2 / 8.4 / 12.6 V = B− / B1 / B2 / B+. Mikkel thinks 2 or 3 bought
charger-3s | 3S Li-ion charger 12.6 V 2 A (EU plug) | Power | 1 | SENNEP V2 | unknown |  | 11.95 | EUR | 89.15 | Bot'n Roll | 2025-05-01
buck-5a | DC-DC step-down 5 A | Power | 2 | SENNEP V2 | unknown |  | 6.98 | GBP | 60.52 | Hobby Components | 2025-04-18 | unknown (often XL4015) |  |  | Meant for the Pi 5 (5 V / 5 A)
lm2596-module | LM2596 step-down module with voltmeter | Power | 3 | SENNEP V2 | unknown |  | 6.73 | GBP | 58.35 | Hobby Components | 2025-04-18 | LM2596 | lm2596.pdf |  | Max 3 A
lm2596t-12 | LM2596T-12 regulator (TO-220, fixed 12 V) | Power | 3 | SENNEP V2 | unknown |  | 24 | DKK | 24.00 | Ardustore | 2024-05-14 | LM2596 | lm2596.pdf
l7805 | L7805 5 V linear regulator (TO-220) | Power | 10 | SENNEP V2 | unknown |  | 20 | DKK | 20.00 | Ardustore | 2024-05-14 | 7805 | l7805.pdf |  | The datasheet is TI's µA7800 (same pinout/function as ST L7805)
ld1117-33 | LD1117V33 3.3 V linear regulator (TO-220) | Power | 3 | SENNEP V2 | unknown |  | 24 | DKK | 24.00 | Ardustore | 2024-05-14 | LD1117 | ld1117-3v3.pdf |  | Max 800 mA. Can supply the esp-01
breadboard-psu | Breadboard power supply (MB102 type) | Power | 2 | SENNEP V2 | unknown |  | 40 | DKK | 40.00 | Ardustore | 2024-05-14 | AMS1117 | ams1117-breadboard-psu.pdf |  | 5 V + 3.3 V for a breadboard
irfz44n | IRFZ44N N-MOSFET (TO-220) | Power | 5 | SENNEP V2 | unknown |  | 30 | DKK | 30.00 | Ardustore | 2024-05-14 | IRFZ44N | irfz44n.pdf |  | Not logic-level: needs ~10 V gate for full conduction
mosfet-55v | N-MOSFET 55 V 41 A (probably IRFZ44N) | Power | 3 | SENNEP V2 | unknown |  | 3.00 | EUR | 22.38 | Bot'n Roll | 2025-05-01 | IRFZ44N (assumed) | irfz44n.pdf
heatsink-to220 | Aluminium heatsink TO-220 | Mechanical | 5 | SENNEP V2 | unknown |  | 25 | DKK | 25.00 | Ardustore | 2024-05-14
relay-40a | Car relay 12 V 40 A, 5-pin | Power | 1 | SENNEP V2 | unknown |  | 7.58 | DKK | 7.58 | AliExpress | 2025-12 |  |  |  | The E-stop drives the relay instead of breaking main power itself
fuse-holder | Fuse holder 5×20 mm with cap | Power | 10 | SENNEP V2 | unknown |  | 3.00 | EUR | 22.38 | Bot'n Roll | 2025-05-01 |  |  |  | For 5×20 glass fuses (small branches: logic, drivers). Not for the 30 A main fuse
blade-fuses | Car blade fuses, 180-piece assortment | Power | 1 | SENNEP V2 | unknown |  | 27.79 | DKK | 27.79 | AliExpress | 2025-12 |  |  |  | No blade holders listed: the 30 A main fuse needs an inline blade holder (shopping list)
xt60 | XT60 male/female pair | Connectors | 2 | SENNEP V2 | unknown |  | 3.00 | EUR | 22.38 | Bot'n Roll | 2025-05-01
estop-40mm | Emergency stop 40 mm | Connectors | 1 | SENNEP V2 | unknown |  | 1.49 | GBP | 12.92 | Hobby Components | 2025-04-18
vl53l0x | VL53L0X ToF distance sensor (laser) | Sensors | 8 | SENNEP V2 | unknown |  | 25.27 | GBP | 219.09 | Hobby Components | 2025-04-18 | VL53L0X | vl53l0x.pdf |  | Same I²C address (0x29) -> used via tca9548a. 8 around the robot
e18-d80nk | E18-D80NK IR proximity sensor (adjustable) | Sensors | 4 | SENNEP V2 | unknown |  | 14.63 | GBP | 126.84 | Hobby Components | 2025-04-18 |  |  |  | Edge detectors in the corners. No official datasheet exists
hc-sr04 | HC-SR04 ultrasonic range finder | Sensors | 4 | SENNEP V2 | unknown |  | 80 | DKK | 80.00 | Ardustore | 2024-05-14 |  | hc-sr04.pdf |  | 5 V logic
mpu-6050 | MPU-6050 accelerometer + gyro | Sensors | 1 | SENNEP V2 | unknown |  | 4.90 | EUR | 36.55 | Bot'n Roll | 2025-05-01 | MPU-6050 | mpu-6050.pdf mpu-6050-register-map.pdf |  | I²C 0x68
qmc5883l | GY-271 magnetometer (QMC5883L) | Sensors | 1 | SENNEP V2 | unknown |  | 18.99 | DKK | 18.99 | AliExpress | 2025-12 | QMC5883L | qmc5883l.pdf |  | I²C 0x0D (not the HMC5883L's 0x1E)
neo-6m | GY-NEO6MV2 GPS module | Sensors | 1 | SENNEP V2 | unknown |  | 16.66 | DKK | 16.66 | AliExpress | 2025-12 | u-blox NEO-6M | neo-6m.pdf |  | UART 9600 baud. To be included (decided)
ina219 | INA219 current/voltage monitor | Sensors | 1 | SENNEP V2 | unknown |  | 14.52 | DKK | 14.52 | AliExpress | 2025-12 | INA219 | ina219.pdf |  | Battery monitoring. Max 26 V
tsl2561 | TSL2561 light sensor | Sensors | 1 | SENNEP V2 | unknown |  | 4.16 | GBP | 36.07 | Hobby Components | 2025-04-18 | TSL2561 | tsl2561.pdf
ds3231 | DS3231 RTC module (ZS-042) | Sensors | 1 | SENNEP V2 | unknown |  | 45 | DKK | 45.00 | Ardustore | 2024-05-14 | DS3231 | ds3231.pdf |  | The ZS-042 has a charging circuit for CR2032. Remove the diode/resistor with a non-rechargeable cell
mic-module | Microphone module with adjustment | Sensors | 5 | SENNEP V2 | unknown |  | 75 | DKK | 75.00 | Ardustore | 2024-05-14 | LM393 | lm393-microphone-module.pdf |  | Digital output via comparator + analog output. Level only, no direction
vs1838b | VS1838B IR receiver 38 kHz | Sensors | 10 | SENNEP V2 | unknown |  | 4.00 | EUR | 29.84 | Bot'n Roll | 2025-05-01 | VS1838B | vs1838b-ir-receiver.pdf |  | Dock beacon (receiver)
door-switch | Magnetic door switch MC-38 (NC) | Sensors | 1 | SENNEP V2 | unknown |  | 25 | DKK | 25.00 | Ardustore | 2024-05-14
lidar-ld19 | LDROBOT LD19 / STL-19P LiDAR (sold as youyeetoo FHL-LD19) | Sensors | 1 | SENNEP V2 | unknown |  |  |  |  | unknown | 2025-05 | LD19 | ld19-stl-19p-datasheet.pdf ld19-development-manual.pdf |  | No receipt. UART 230400 baud, 3.3 V logic. Test app in Lidar Test Enviornment/
pi-ai-camera | Raspberry Pi AI Camera (IMX500, 12 MP) | Sensors | 1 | SENNEP V2 | unknown |  | 84.90 | EUR | 633.35 | Bot'n Roll | 2025-05-01 | Sony IMX500 | pi-ai-camera.pdf | https://www.raspberrypi.com/documentation/accessories/ai-camera.html
nrf24l01 | NRF24L01 2.4 GHz radio module | Communication | 3 | SENNEP V2 | unknown |  | 60 | DKK | 60.00 | Ardustore | 2024-05-14 | nRF24L01+ | nrf24l01.pdf |  | 3.3 V supply (5 V-tolerant pins). Manual control / RF joystick
esp-01 | ESP8266 ESP-01 WiFi module | Communication | 1 | SENNEP V2 | unknown |  | 25 | DKK | 25.00 | Ardustore | 2024-05-14 | ESP8266EX | esp8266ex.pdf esp8266-at-commands.pdf | esp-01/README.md | Probably never used. 3.3 V ONLY: do not use the Mega's 3V3 pin. Pinout, diagram and code in esp-01/
tca9548a | TCA9548A I²C multiplexer (8 channels) | Communication | 5 | SENNEP V2 | unknown |  | 34.83 | DKK | 34.83 | AliExpress | 2025-12 | TCA9548A | tca9548a.pdf |  | Solves all 8 VL53L0X sharing one address. I²C 0x70-0x77
level-converter | 4-channel logic level converter 3.3 V <-> 5 V | Communication | 1 | SENNEP V2 | unknown |  | 11.35 | DKK | 11.35 | AliExpress | 2025-12 | BSS138 | bss138-level-converter.pdf |  | Bidirectional (BSS138). Fine for I²C and UART
cp2102 | CP2102 USB-UART adapter (came with the LiDAR kit) | Communication | 1 | SENNEP V2 | unknown |  |  |  |  |  |  |  |  |  | Connects the LiDAR to the Pi 5 over USB (added in consolidation 2026-10-12, not counted yet)
screen-7 | 7" HDMI LCD (C) 1024×600 IPS, touch (Waveshare) | UI | 1 | SENNEP V2 | unknown |  | 64.90 | EUR | 484.15 | Bot'n Roll | 2025-05-01 |  |  | https://www.waveshare.com/wiki/7inch_HDMI_LCD_(C) | Mounting holes did not match in the laser-cut test
lcd-20x4 | 20×4 LCD, white | UI | 2 | SENNEP V2 | unknown |  | 160 | DKK | 160.00 | Ardustore | 2024-05-14 | HD44780 | hd44780-lcd.pdf
lcd-16x2 | 16×2 LCD, white | UI | 4 | SENNEP V2 | unknown |  | 240 | DKK | 240.00 | Ardustore | 2024-05-14 | HD44780 | hd44780-lcd.pdf
i2c-lcd-adapter | I²C adapter for LCD (backpack) | UI | 6 | SENNEP V2 | unknown |  | 120 | DKK | 120.00 | Ardustore | 2024-05-14 | PCF8574 | pcf8574-i2c-lcd-adapter.pdf |  | I²C 0x27 (PCF8574) or 0x3F (PCF8574A)
keypad-3x4 | Membrane keypad 3×4 | UI | 1 | SENNEP V2 | unknown |  | 15 | DKK | 15.00 | Ardustore | 2024-05-14
voltmeter-display | 0.28" voltmeter display 0–30 V | UI | 1 | SENNEP V2 | unknown |  | 9.46 | DKK | 9.46 | AliExpress | 2025-12
dfplayer | DFPlayer Mini MP3 player | Sound | 2 | SENNEP V2 | unknown |  | 60 | DKK | 60.00 | Ardustore | 2024-05-14 | FN-M16P | dfplayer-mini.pdf |  | UART 9600 baud. Use 1 kΩ in series on RX with 5 V logic
dfplayer-2 | DFPlayer Mini MP3 player | Sound | 1 | SENNEP V2 | unknown |  | 9.90 | EUR | 73.85 | Bot'n Roll | 2025-05-01 | FN-M16P | dfplayer-mini.pdf |  | 3 in total together with dfplayer
speaker-1w | Speaker 1 W 8 Ω with adhesive gasket | Sound | 8 | SENNEP V2 | unknown |  | 5.53 | GBP | 47.95 | Hobby Components | 2025-04-18
pam8403 | PAM8403 mini amplifier 2×3 W (5 pcs) | Sound | 5 | SENNEP V2 | unknown |  | 11.87 | DKK | 11.87 | AliExpress | 2025-12 | PAM8403 | pam8403.pdf |  | 5 V supply
ws2812b | WS2812B LED strip 5 m, 30 LED/m | Lighting | 1 | SENNEP V2 | unknown |  | 52.30 | DKK | 52.30 | AliExpress | 2025-12 | WS2812B | ws2812b.pdf |  | 150 LEDs -> up to ~9 A at full white. 5 V
led-3w | 3 W LED module | Lighting | 4 | SENNEP V2 | unknown |  | 11.80 | EUR | 88.03 | Bot'n Roll | 2025-05-01 |  |  |  | Head-lights. Need current limiting
ir-led-940 | IR LED 940 nm | Lighting | 10 | SENNEP V2 | unknown |  | 6.00 | EUR | 44.76 | Bot'n Roll | 2025-05-01 |  |  |  | Dock beacon (transmitter)
joystick-ky023 | KY-023 analog joystick (XY + button) | Control | 4 | SENNEP V2 | unknown |  | 60 | DKK | 60.00 | Ardustore | 2024-05-14
potentiometer | Potentiometer, horizontal | Control | 5 | SENNEP V2 | unknown |  | 10 | DKK | 10.00 | Ardustore | 2024-05-14
key-switch | Key switch S1203 12 mm on/off | Connectors | 1 | SENNEP V2 | unknown |  | 18 | DKK | 18.00 | Ardustore | 2024-05-14
toggle-mts103 | Toggle switch MTS-103 on-off-on 6 A | Connectors | 1 | SENNEP V2 | unknown |  | 7 | DKK | 7.00 | Ardustore | 2024-05-14
pushbutton-red | Push button PBS-110 red | Connectors | 1 | SENNEP V2 | unknown |  | 5 | DKK | 5.00 | Ardustore | 2024-05-14
screw-terminal-3p | Screw terminal 3-pole 5.0 mm, blue (10 per pack) | Connectors | 3 | SENNEP V2 | unknown |  | 3.28 | GBP | 28.44 | Hobby Components | 2025-04-18 |  |  |  | 3 packs = 30 pcs
jst-ph-2 | JST PH 2.0 mm connector, 2-pole | Connectors | 5 | SENNEP V2 | unknown |  | 1.00 | EUR | 7.46 | Bot'n Roll | 2025-05-01
jst-ph-3 | JST PH 2.0 mm connector, 3-pole | Connectors | 5 | SENNEP V2 | unknown |  | 1.00 | EUR | 7.46 | Bot'n Roll | 2025-05-01
9v-clip | DC plug for 9 V battery clip | Connectors | 2 | SENNEP V2 | unknown |  | 0.75 | GBP | 6.50 | Hobby Components | 2025-04-18
cable-10awg | Silicone cable 10 AWG, 2 m | Cables | 3 | SENNEP V2 | unknown |  | 114.75 | DKK | 114.75 | AliExpress | 2025-12
cable-16awg | Cable 16 AWG, 10 m | Cables | 1 | SENNEP V2 | unknown |  | 59.96 | DKK | 59.96 | AliExpress | 2025-12
cable-22awg | Cable 22 AWG, 50 m (5×10 m) | Cables | 1 | SENNEP V2 | unknown |  | 74.01 | DKK | 74.01 | AliExpress | 2025-12
alligator-leads | Alligator clip leads, 10 pcs | Cables | 1 | SENNEP V2 | unknown |  | 3.90 | EUR | 29.09 | Bot'n Roll | 2025-05-01
ceramic-kit | Ceramic capacitors, 300 pcs (2 pF–0.1 µF) | Passives | 1 | SENNEP V2 | unknown |  | 1.99 | GBP | 17.25 | Hobby Components | 2025-04-18
electrolytic-kit | Electrolytic capacitors, 120 pcs | Passives | 1 | SENNEP V2 | unknown |  | 3.09 | GBP | 26.79 | Hobby Components | 2025-04-18
smd-diodes | SMD diodes, 70 pcs | Passives | 1 | SENNEP V2 | unknown |  | 1.49 | GBP | 12.92 | Hobby Components | 2025-04-18
fan-40mm | Fan 40×40 mm brushless DC | Mechanical | 4 | SENNEP V2 | unknown |  | 2.63 | GBP | 22.80 | Hobby Components | 2025-04-18 |  |  |  | Voltage not stated on the invoice
protoboard-12x18 | Protoboard double-sided 12×18 cm | Mechanical | 4 | SENNEP V2 | unknown |  | 6.43 | GBP | 55.75 | Hobby Components | 2025-04-18
solderable-breadboard | Solderable breadboard, 400 holes | Mechanical | 1 | SENNEP V2 | unknown |  | 10.16 | DKK | 10.16 | AliExpress | 2025-12
hex-screw-assortment | Stainless hex socket screws, 290-piece assortment | Mechanical | 1 | SENNEP V2 | unknown |  | 63.62 | DKK | 63.62 | AliExpress | 2025-12 |  |  |  | Sizes unknown
insert-m3 | Brass threaded inserts M3, 100 pcs | Mechanical | 1 | SENNEP V2 | unknown |  | 41.52 | DKK | 41.52 | AliExpress | 2025-12 |  |  |  | Melted in with the soldering iron
petg | PETG filament (kg) | Consumables | 15 | SENNEP V2 | unknown |  |  |  |  | unknown |  |  |  |  | 15 kg was the stock in 2025
solder | Solder 1.0 mm, 100 g | Consumables | 1 | SENNEP V2 | unknown |  | 95 | DKK | 95.00 | Ardustore | 2024-05-14
thermal-paste | Silicone thermal paste, 30 g | Consumables | 1 | SENNEP V2 | unknown |  | 75 | DKK | 75.00 | Ardustore | 2024-05-14
side-cutters | Side cutters 125 mm | Tools | 1 | SENNEP V2 | unknown |  | 45 | DKK | 45.00 | Ardustore | 2024-05-14
tap-die-set | Tap & die set M3–M12 | Tools | 1 | other project | unknown |  |  |  |  |  |  |  |  |  | Used to cut the printed M8 bolts (added in consolidation 2026-10-12, not counted yet)
soldering-station | Puctec ZD-99 soldering station 48 W | Tools | 1 | other project | unknown |  |  |  |  |  |  |  |  |  | Too weak for cells; OK for BMS pads and nickel tabs ≥ 10 mm from cells (added in consolidation 2026-10-12, not counted yet)
multimeter-fluke83 | Fluke 83 multimeter | Tools | 1 | other project | ok |  |  |  |  |  |  |  |  |  | (added in consolidation 2026-10-12, not counted yet)
printer-x1c | Bambu Lab X1C 3D printer | Tools | 1 | other project | ok |  |  |  |  |  |  |  |  |  | 220 mm usable plate (added in consolidation 2026-10-12, not counted yet)
calipers | Calipers | Tools | 1 | other project | unknown |  |  |  |  |  |  |  |  |  | (added in consolidation 2026-10-12, not counted yet)
screwdrivers | Screwdriver set (≤ Ø16 × 150 mm) | Tools | 1 | other project | unknown |  |  |  |  |  |  |  |  |  | Sizes set the housing tool channels (added in consolidation 2026-10-12, not counted yet)
lipo-charger-b3 | HobbyKing B3 AC compact LiPo charger | Tools | 1 | SENNEP V1 | unknown |  |  |  |  |  |  |  |  |  | (added in consolidation 2026-10-12, not counted yet)
breadboards | Breadboards + Dupont jumpers | Tools | 1 | other project | unknown |  |  |  |  |  |  |  |  |  | Quantity unknown (added in consolidation 2026-10-12, not counted yet)
filament-tpu | TPU filament | Consumables | 1 | other project | unknown |  |  |  |  |  |  |  |  |  | Amount left unknown (added in consolidation 2026-10-12, not counted yet)
screw-kit-m2-m4 | Old M2–M4 screw kit (M3×12/×19 ×20 each, M4×12 ×20, M4×25 ×10, nuts, washers) | Hardware | 1 | other project | unknown |  |  |  |  |  |  |  |  |  | (added in consolidation 2026-10-12, not counted yet)
resistor-kit | Resistor assortment kit | Passives | 1 | other project | unknown |  |  |  |  |  |  |  |  |  | Many values (added in consolidation 2026-10-12, not counted yet)
lipo-zippy-1000 | Zippy Compact 35C LiPo 1000 mAh 3S 11.1 V (XT60) | Power | 1 | SENNEP V1 | used |  |  |  |  |  |  |  |  |  | No BMS. Fried V1's Mega: only use with a fuse < 10 cm from the XT60 and a LiPo alarm (added in consolidation 2026-10-12, not counted yet)
adapter-12v | 12 V power adapter | Power | 1 | other project | unknown |  |  |  |  |  |  |  |  |  | Rating unknown (≥ 3 A needed for bench logic) (added in consolidation 2026-10-12, not counted yet)
