MikkelBlom/SENNEP-V2/print/chassis_v1/4x_Rail.stl

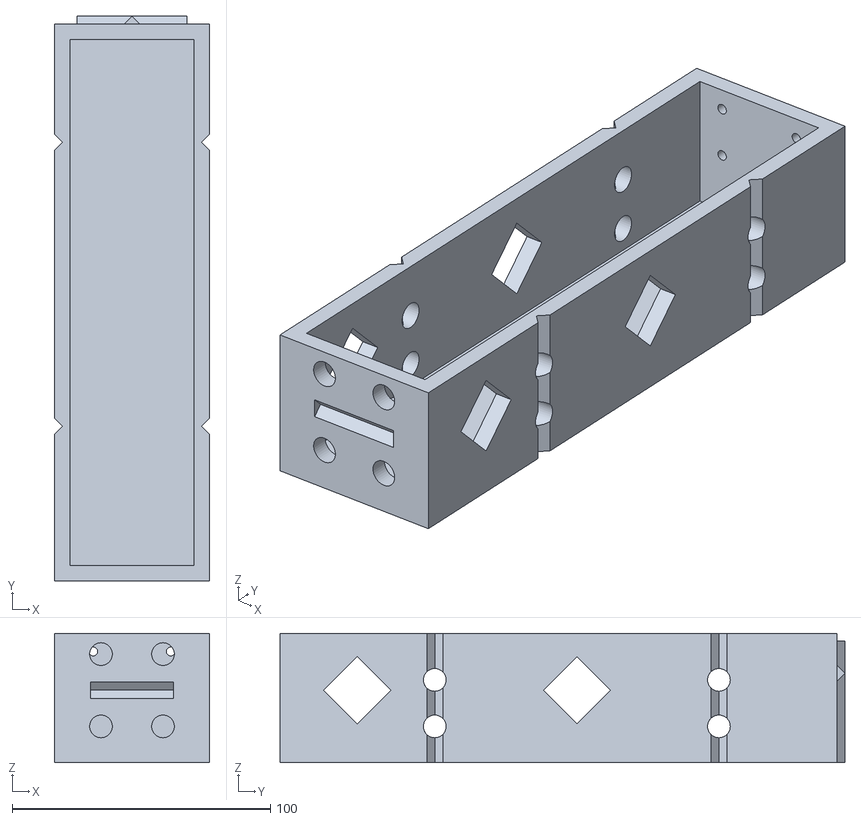
[picture p16: CAD file, 2026-10-13]
print/chassis_v1/4x_Rail.stl
60.0 x 218.7 x 50.0
