MikkelBlom/SENNEP-V2/print/skelet_test/1x_Test_tvaerbjaelke_ende.stl

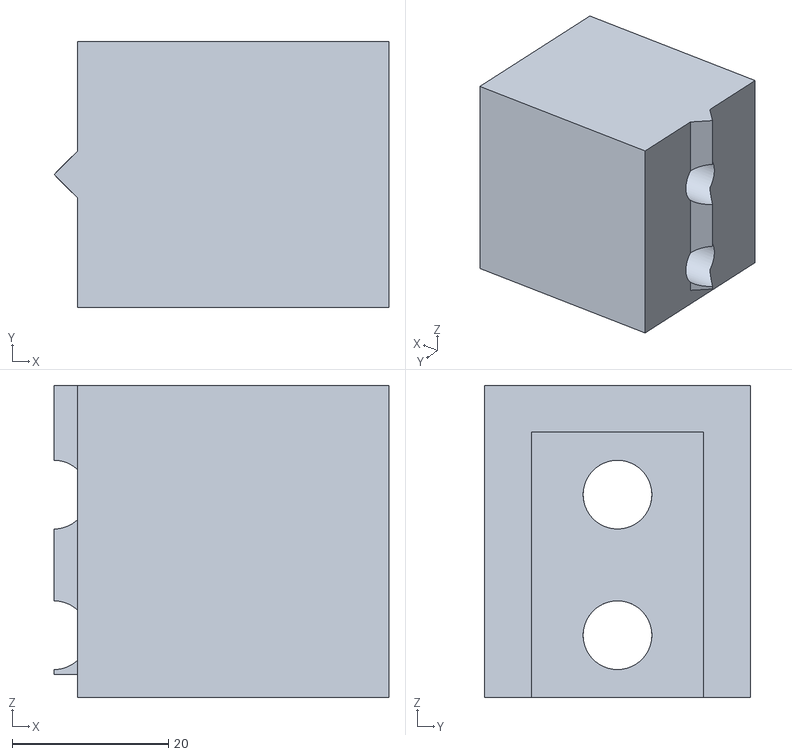
[picture p18: CAD file, 2026-10-12]
print/skelet_test/1x_Test_tvaerbjaelke_ende.stl
42.9 x 34.0 x 40.0
