MikkelBlom/SENNEP-V2/print/testhjul_v3.1/1x_RimB_outer.stl

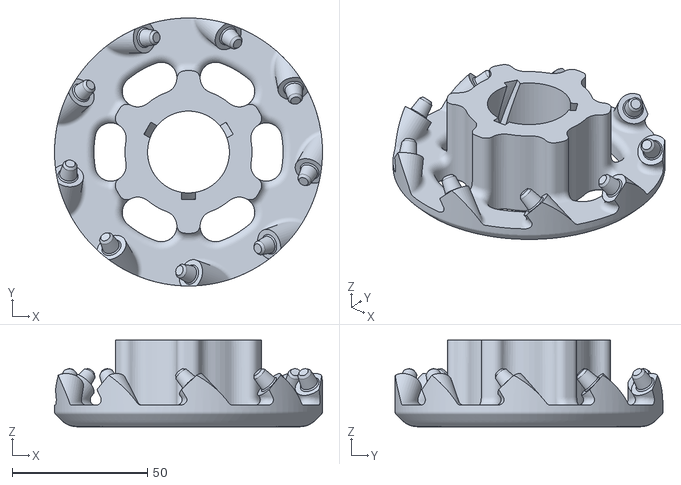
[picture p19: CAD file, 2026-10-12]
print/testhjul_v3.1/1x_RimB_outer.stl
99.2 x 99.2 x 32.0
