MikkelBlom/SENNEP-V2/print/testhjul_v3.1/hjulkasse/1x_Motor_collar.stl

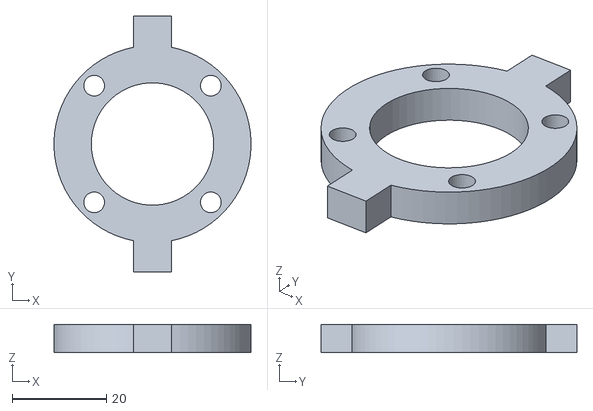
[picture p20: CAD file, 2026-10-12]
print/testhjul_v3.1/hjulkasse/1x_Motor_collar.stl
41.9 x 54.4 x 6.00
