MikkelBlom/SENNEP-V2/print/testhjul_v3.1/samlering/Samlering_med_TPU_sleeves.stl

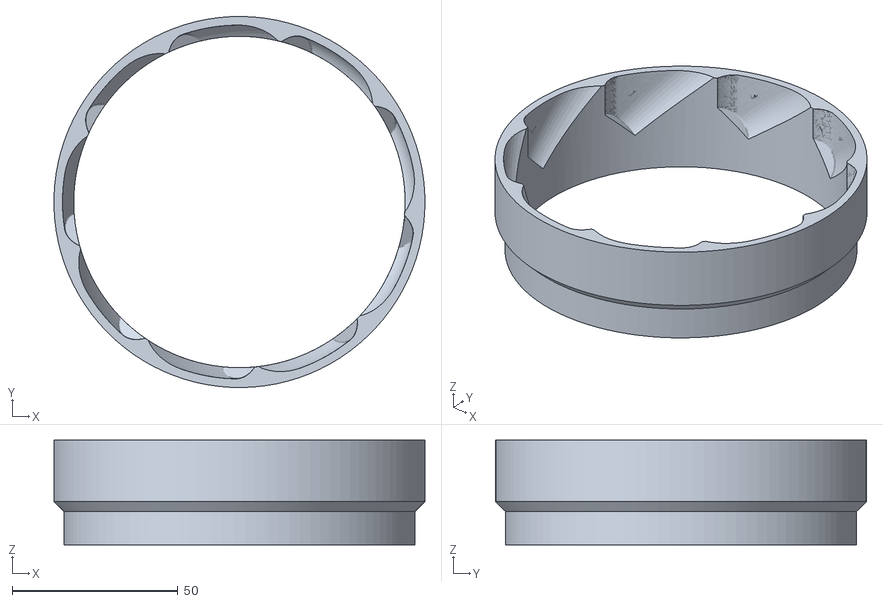
[picture p21: CAD file, 2026-10-12]
print/testhjul_v3.1/samlering/Samlering_med_TPU_sleeves.stl
112.0 x 112.0 x 31.5
