MikkelBlom/SENNEP-V2/print/housing_v2/1x_Housing_hul_variant.stl

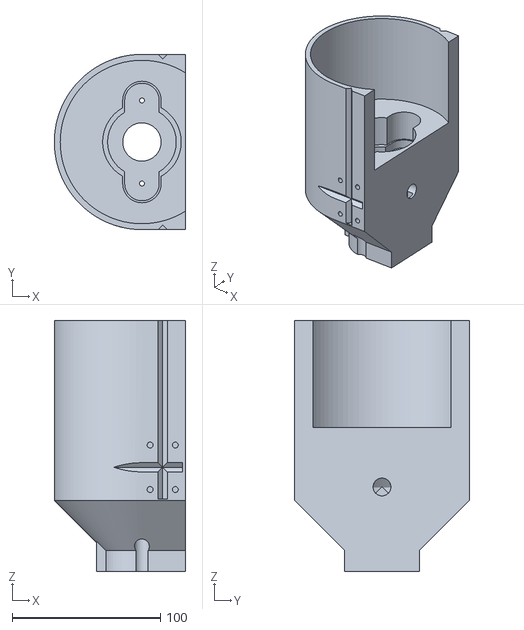
[picture p22: CAD file, 2026-10-12]
print/housing_v2/1x_Housing_hul_variant.stl
88.6 x 118.2 x 169.3
