MikkelBlom/SENNEP-V2/print/skelet_test/1x_P-M8_moetrik.stl

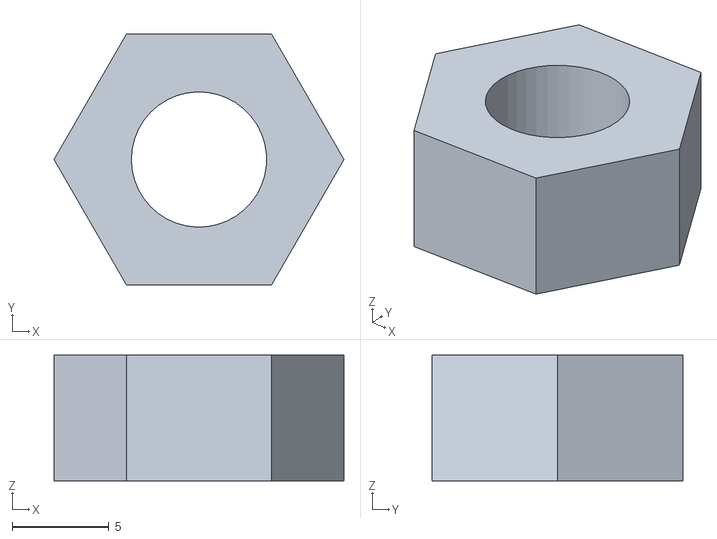
[picture p23: CAD file, 2026-10-12]
print/skelet_test/1x_P-M8_moetrik.stl
15.0 x 13.0 x 6.50
