MikkelBlom/SENNEP-V2/print/testhjul_v3.1/1x_Axle.stl

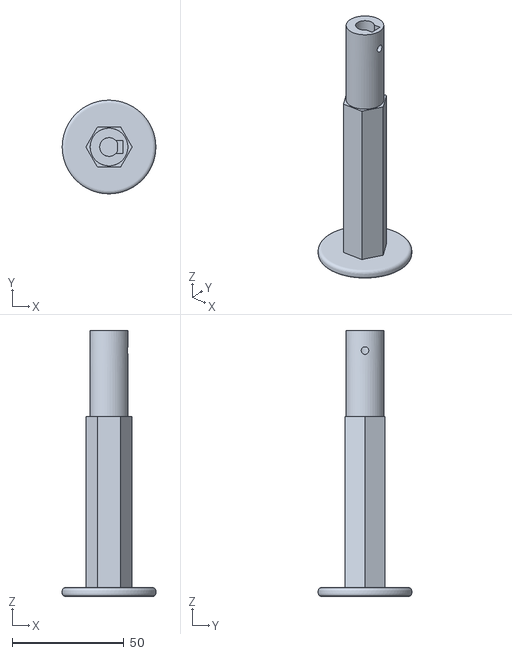
[picture p24: CAD file, 2026-10-12]
print/testhjul_v3.1/1x_Axle.stl
42.0 x 42.0 x 119.3
