MikkelBlom/SENNEP-V2/print/testhjul_v3.1/hjulkasse/1x_Bearing_keeper.stl

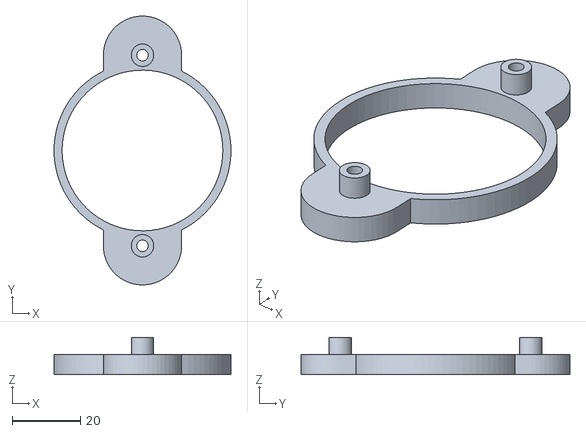
[picture p25: CAD file, 2026-10-12]
print/testhjul_v3.1/hjulkasse/1x_Bearing_keeper.stl
52.0 x 79.0 x 11.0
