MikkelBlom/SENNEP-V2/print/testhjul_v3.1/spejlvendt/2x_RimA_motorside_SPEJLVENDT.stl

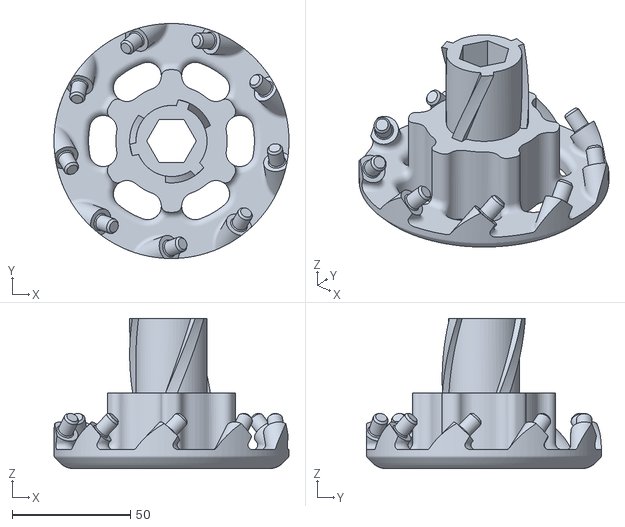
[picture p26: CAD file, 2026-10-14]
print/testhjul_v3.1/spejlvendt/2x_RimA_motorside_SPEJLVENDT.stl
99.2 x 99.2 x 63.5
