MikkelBlom/SENNEP-V2/print/skelet_test/1x_Test_rail_stykke.stl

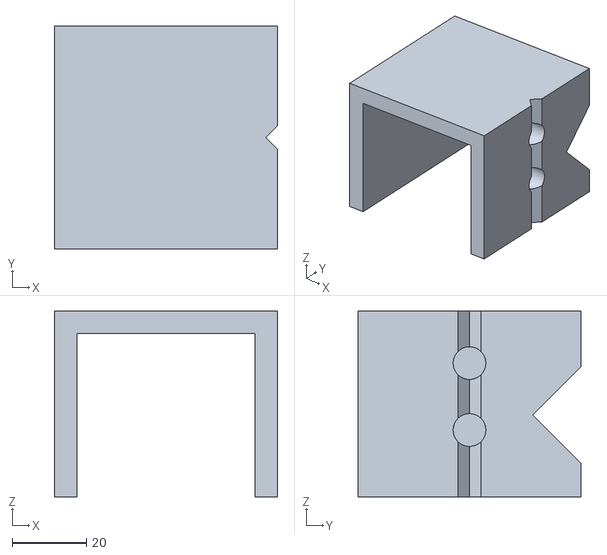
[picture p27: CAD file, 2026-10-12]
print/skelet_test/1x_Test_rail_stykke.stl
60.0 x 60.0 x 50.0
