MikkelBlom/SENNEP-V2/print/testhjul_v3.1/9x_Roller_core_PETG.stl

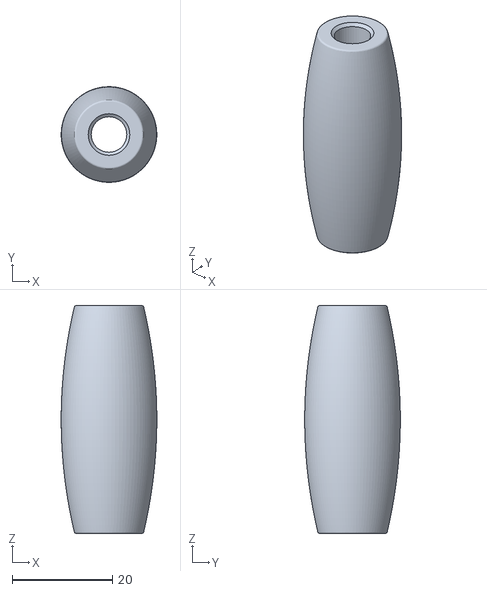
[picture p28: CAD file, 2026-10-12]
print/testhjul_v3.1/9x_Roller_core_PETG.stl
19.1 x 19.1 x 45.5
