MikkelBlom/SENNEP-V2/print/chassis_v1/4x_Cross_half.stl

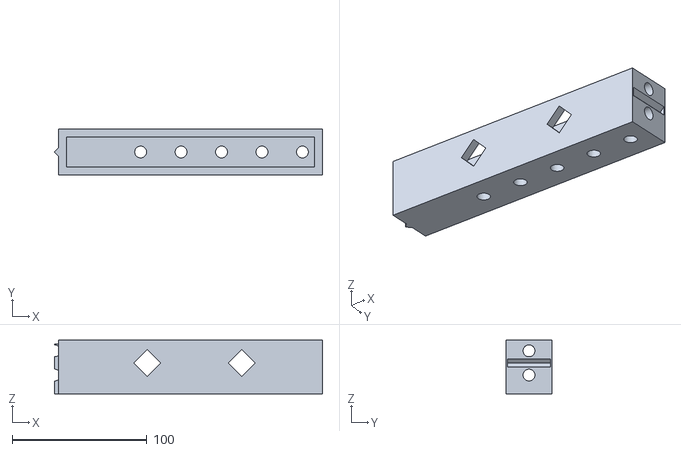
[picture p29: CAD file, 2026-10-13]
print/chassis_v1/4x_Cross_half.stl
198.8 x 34.0 x 40.0
