MikkelBlom/SENNEP-V2/print/chassis_v1/4x_Key_bar.stl

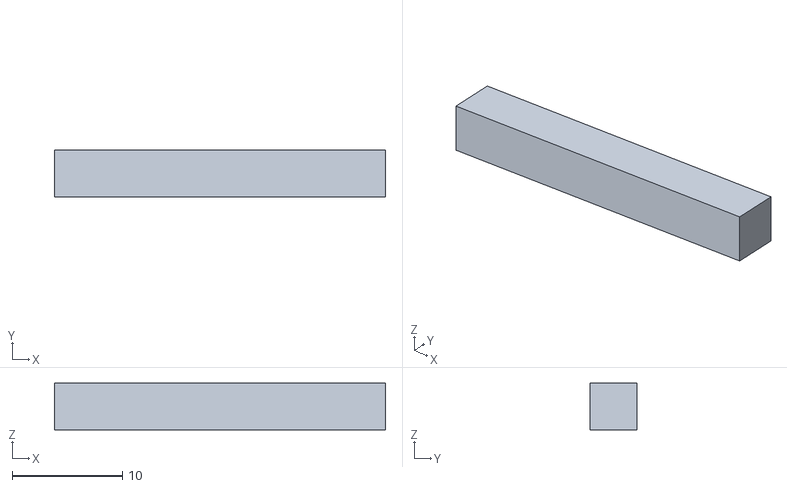
[picture p30: CAD file, 2026-10-13]
print/chassis_v1/4x_Key_bar.stl
30.0 x 4.24 x 4.24
