MikkelBlom/SENNEP-V2/print/skelet_test/2x_P-M8_skive.stl

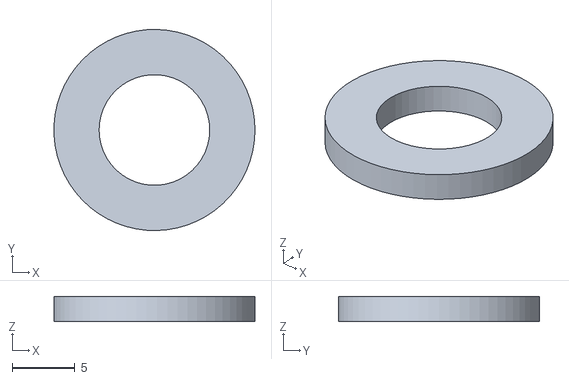
[picture p31: CAD file, 2026-10-12]
print/skelet_test/2x_P-M8_skive.stl
16.0 x 16.0 x 2.00
