MikkelBlom/SENNEP-V2/print/testhjul_v3.1/9x_Roller_sleeve_TPU.stl

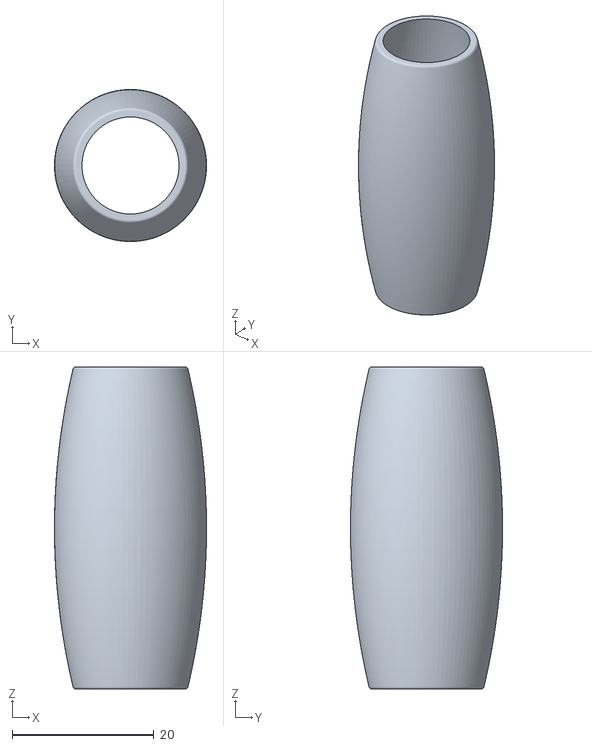
[picture p32: CAD file, 2026-10-12]
print/testhjul_v3.1/9x_Roller_sleeve_TPU.stl
21.5 x 21.5 x 45.5
