MikkelBlom/SENNEP-V2/print/testhjul_v3.1/1x_Spacer.stl

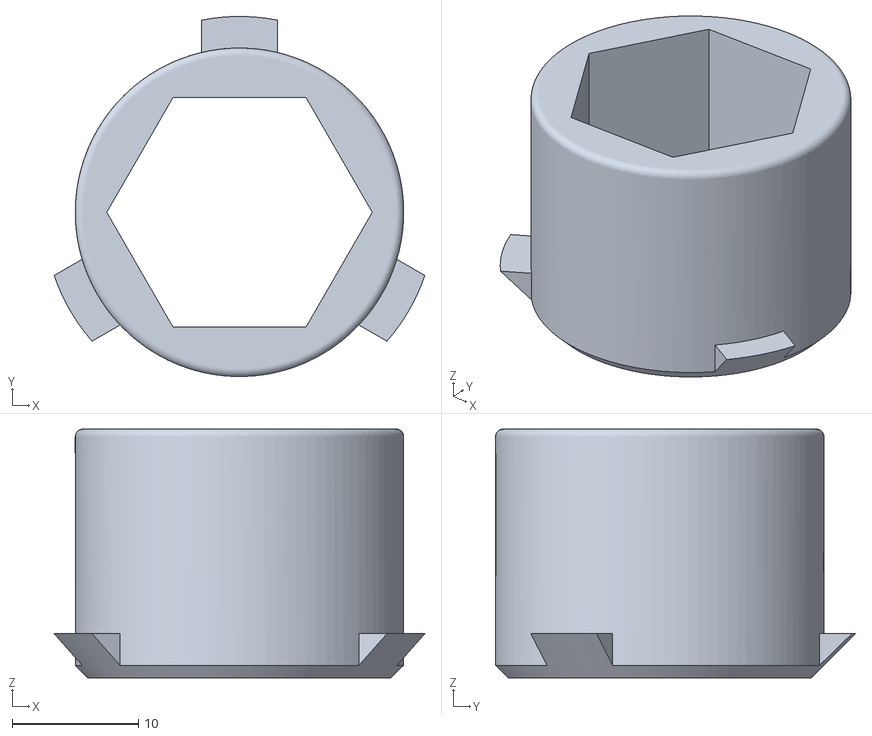
[picture p33: CAD file, 2026-10-12]
print/testhjul_v3.1/1x_Spacer.stl
29.3 x 28.5 x 19.7
