MikkelBlom/SENNEP-V2/(list of files, cad)

Other CAD files:
print/testhjul_v3.1/spejlvendt/2x_RimB_outer_SPEJLVENDT.stl
print/testhjul_v3.1/samlering/Samlering_uden_sleeves.stl
print/housing_v2/1x_Motor_collar.stl
print/testhjul_v3.1/hjulkasse/1x_Pod_hjulkasse.stl
print/testhjul_v3.1/spejlvendt/1x_Samlering_med_TPU_sleeves_SPEJLVENDT.stl
print/housing_v2/1x_Bearing_keeper.stl
print/testhjul_v3.1/1x_RimA_motorside.stl
print/testhjul_v3.1/spejlvendt/1x_Samlering_uden_sleeves_SPEJLVENDT.stl
print/chassis_v1/20x_P-M8_nut.stl
print/chassis_v1/20x_P-M8x22_bolt.stl
print/skelet_test/1x_P-M8x26_bolt.stl
print/testhjul_v2.7/1x_Axle.stl
print/testhjul_v2.7/1x_RimA_motorside.stl
print/testhjul_v2.7/1x_RimB_outer.stl
print/testhjul_v2.7/1x_Spacer.stl
print/testhjul_v2.7/9x_Roller_core_PETG.stl
print/testhjul_v2.7/9x_Roller_sleeve_TPU.stl
print/testhjul_v3/1x_Axle.stl
print/testhjul_v3/1x_RimA_motorside.stl
print/testhjul_v3/1x_RimB_outer.stl
print/testhjul_v3/1x_Spacer.stl
print/testhjul_v3/9x_Roller_core_PETG.stl
print/testhjul_v3/9x_Roller_sleeve_TPU.stl
print/testhjul_v3/hurtigtest/Test_Axle_hex.stl
print/testhjul_v3/hurtigtest/Test_RimA_spacer_socket.stl
print/testhjul_v3/hurtigtest/Test_RimA_tube_end.stl
print/testhjul_v3/hurtigtest/Test_RimB_hub.stl
print/testhjul_v3/hurtigtest/Test_Spacer.stl
