MikkelBlom/SENNEP-V2/ai-instructions/SESSIONS.md

# Sessions

## 2026-10-04 — Claude Code (Opus 5.5)
**Summary:** Rekonstruerede projektideen. Læste Gemini-share-linket (hele, ~110k tegn), `samtale-2.pdf` (motor/driver, 11 sider, billed-PDF), tre kvitteringer, `Cut noter.txt` og skimmede `Lidar Test Enviornment/`. Resultat i `PROJECT_OVERVIEW.md`.
**Issues:** `Samtale.pdf` er samme samtale som share-linket (billed-PDF, ikke læst separat). ChatGPT-projektet findes ikke i mappen. Mappen er ikke et git-repo. LiDAR-testappens `next build` fejler på en typefejl (`onCalibrationProgress` mangler i preload-typerne).
**Next:** Afklar Pi 4/5 + hjulstatus; byg "rullende skelet" (bundramme + motorer + hjul + batteri + Nano + L298N + RF-joystick) før karosseri; derefter strøm-/sensor-hub-design.

## 2026-10-04 (forts.) — Claude Code (Opus 5.5)
**Summary:** Gennemgik Gmail for AliExpress: 18 ordrer fra 17.–22. dec 2025, ~883 kr (tabel i PROJECT_OVERVIEW.md §4). Ordren løser flere tidligere flag (motordrivere, multiplexer, relæ til nødstop, INA219). Pi 5 bekræftet, hjul printet/testet, 100 % print foretrukket. Fandt officiel Autodesk Fusion MCP (Fusion → Preferences → General → API → Fusion MCP Server).
**Issues:** ChatGPT-projektlinket kræver login (ikke læst). Fusion-modellen ikke delt endnu.
**Next:** Forbind Fusion MCP eller eksportér STEP; design rullende skelet (bundramme i printbare segmenter).

## 2026-10-05 — Claude Code (Opus 5.5)
**Summary:** Læste hele `gpttxt.txt` (1950 linjer, ChatGPT apr–maj 2025) → tidslinje i PROJECT_OVERVIEW.md §7b. Registrerede Fusion MCP lokalt (`claude mcp add --transport http fusion http://127.0.0.1:27182/mcp`, local scope i ~/.claude.json). Hjul/lejer afklaret (pillow blocks bærer vægten).
**Issues:** Mange brugerbeskeder i gpttxt refererer til billeder, der ikke er med (afventer zip). Vandsikringskrav fra apr 2025 konflikter med luftindtag fra maj 2025.
**Next:** Ny session → test Fusion MCP-forbindelse, læs modellen, planlæg krop + sensorplacering.

## 2026-10-05 (forts.) — Claude Code (Opus 5.5)
**Summary:** Fusion MCP virker via claude.ai-connectoren (Autodesk_Fusion). Læste "Robot v58" read-only: skal 500×816×200, Ø130 hjul, kun ét hjørnemodul modelleret. Resultat i PROJECT_OVERVIEW.md §7c. Afklaret: ikke vandtæt, GPS med, batteriserier ikke forbundet.
**Issues:** For at se ind i modellen blev Body422/433/434 skjult og vist igen; dokumentet står derfor som "modified" uden reelle ændringer (ingen grund til at gemme). Fusion-scripts skal definere `run(context)`.
**Next:** Afklar målstørrelse; spejl hjørnemodulet ×4; del skal + bundplade i printbare paneler; placér komponenter.

## 2026-10-05 (forts. 2) — Claude Code (Opus 5.5)
**Summary:** Satte nyt Fusion-dokument "SENNEP V2" op (parametre, komponentstruktur, layout-skitse, Drive Module ×4 importeret fra Robot v59). Gemt som v1/v2. Detaljer i PROJECT_OVERVIEW.md §9. Fandt motorens datablad (§7d).
**Issues:** Joints til layout-punkter fejlede → positioner sat med transformationer. Spejlvendte hjul til FR/RL mangler.
**Next:** Spejlet hjulvariant; stigeramme i 20 Chassis efter parametre; stålaksel-beslutning; elektronik-pladsholdere.

## 2026-10-05 (forts. 3) — Claude Code (Opus 5.5)
**Summary:** Hjulgenerator v2.0→v2.6.1 (100 % printet hjul): printede pinde, aksel, afstandsrør, finish, Mikkels egne features indarbejdet fra tidslinjen, helix-riller mellem fælgene, asymmetriske pinde (fundet via automatisk samletest), bajonet på afstandsrør, skrue-joint med motion link. STL til testprint eksporteret. Detaljer: PROJECT_OVERVIEW.md §11–12.
**Issues:** Nested occurrence-transforms upålidelige via API → ruller som bodies. Bash-heredoc mangler `\n`-escapes → patches skrevet som filer i scratchpad.
**Next:** Testprint → justér frigange; venstre/højre hjul i drivmodulet; hjulkasse.

## 2026-10-05 (forts. 4) — Claude Code (Opus 5.5)
**Summary:** Testprint af v2.7 evalueret (5 problemer) → hjulgenerator v3: printbar bajonet, korte pinde + trykring, strammere pasninger, Ø21,5-ruller der virker uden sleeve, hurtigtest-dele. Detaljer: PROJECT_OVERVIEW.md §12 "v3". STL i print/testhjul_v3. Fusion v14.
**Issues:** Fusion MCP timer ud ved to builds i ét kald → én build pr. kald. Større ruller end Ø22 er umulige ved 9 ruller/Ø106.
**Next:** Mikkel printer hurtigtest → justér pasninger → helt hjul. Derefter venstre/højre hjul i drivmodulet og hjulkasse.

## 2026-10-05 (forts. 5) — Claude Code (Opus 5.5)
**Summary:** Bajonetten er lavet om efter Mikkels kritik: én 45°-profil med trekantede tapper i stedet for lappeløsninger. Ingen overhang er verificeret med et automatisk tjek af face-normaler. STL re-eksporteret, Fusion v15.
**Lesson:** Design hele profilen som én linje fra start. Tjek altid printorienteringen (hvilken flade ligger på pladen), før der tilføjes "printbar" geometri.

## 2026-10-05 (forts. 6) — Claude Code (Opus 5.5)
**Summary:** Akslen: pinolskruen sidder nu i en indfanget M3-møtrik i en lomme, der er åben mod koblingsenden. Ingen printpause, 1,7 mm væg udenfor møtrikken. Gevind skåret i plast (M5) flækkede akslen langs laget, og en M4-møtrik er der ikke plads til. Fusion v16, STL re-eksporteret. Skrev `HANDOFF_CHASSIS.md`: prompt til en ny chat om skelettet (stel, motor- og lejeophæng) med grænsefladen til hjulet og alle print-erfaringer.
**Next:** Mikkel printer hurtigtest + aksel. Skelettet laves i en separat chat. Hjulchatten fortsætter med pasninger og venstre/højre hjul.
- Rettelse (v17): væggen på 0,4 mm mellem møtriklommen og D-hullet er fjernet. Møtrikken ligger nu i flugt med D-fladen; den er 5,5 mm bred mod en åbning på 4 mm, så den kan ikke falde ind i hullet. Væggen udenfor er nu 2,1 mm. Koblingen kan ikke gøres tykkere, fordi den skal gennem lejet (maks. Ø16,9).
- v18: møtriklommen har nu lige vægge helt ned til hullet (ingen knivtynde trekanter). Møtrikken kan derfor glide ind i hullet, før motorakslen sidder i: skru pinolskruen et par omgange i møtrikken først, så holder den møtrikken.

## 2026-10-05 (forts. 7) — Claude Code (Opus 5.5), skelet-chat
**Summary:** Læste HANDOFF_CHASSIS og lavede udkast 1 til et parametrisk skelet (`docs/skelet_udkast_v1.html`, artifact). Intet modelleret i Fusion; kun read-only-scripts (parametre, gamle KFL003/motor-mål). Motordatablad s. 4 aflæst (4× M4 på PCD 35, tap Ø25). Detaljer: PROJECT_OVERVIEW §13.
**Issues:** Ved RobotWidth 500 overlapper venstre/højre motor (−11,5 mm) → anbefalet 540. KFL003 er selvjusterende, så momentet fra hjulet kan ende i motorakslen; skal testes. Wheel_Width-parameter findes ikke (kun WheelWidth 55, forældet).
**Next:** Mikkel: bredde, KFL003-mål, terminallængde, batterimål, lejetest, ok til flydende motor. Derefter generator v0 med ét pod.

## 2026-10-05 (forts. 8) — Claude Code (Opus 5.5), skelet-chat
**Summary:** Mikkel valgte 800 × 650 og 220 mm printgrænse. Skrev `SENNEP_ChassisGenerator` v0 og byggede ét hjørne ("21 Pod Lab") om det genererede hjul med de rigtige motor- og lejemodeller. Alle tjek er grønne. Fusion gemt. Skærmbilleder i `docs/skelet/`. Detaljer: PROJECT_OVERVIEW §13 "Skelet v0".
**Issues:** Proxy-transforms blev nulstillet af en parameterændring sidst i scriptet (løst). Gearkassens diameter er uenig mellem model (41,5) og datablad (42,4).
**Next:** Mikkel ser hjørnet i 3D og måler gearkassen. Derefter: 4 spejlede pods, skinner/gulv, udhuling, STL + testprint af ét hjørne.

## 2026-10-05 (forts. 9) — Claude Code (Opus 5.5), skelet-chat
**Summary:** Skelet v1: rund hjulkasse, rundt skruetrækkerhul, gearkasse Ø42,4 (datablad), dråbehuller overalt på tværs. Ny `build_chassis()` laver hele det rullende skelet (4 pods + 12 bundbakker) i "20 Chassis". Alle tjek er grønne. Fusion gemt. Skærmbilleder i `docs/skelet/`. Detaljer: PROJECT_OVERVIEW §13 "Skelet v1".
**Issues:** `SurfaceEvaluator` har ingen `getParameterExtents` → brug `parametricRange()`. Kameraets `viewExtents` opfører sig mærkeligt efter et ortho-kamera; `isFitView = True` virker.
**Next:** Mikkel vurderer. Derefter udhuling af pods, lukning af gulvhullerne, STL + testprint af ét hjørne + én bakke.

## 2026-10-06 — Claude Code (Opus 5.5), skelet-chat
**Summary:** Rettede to fejl, som Mikkel fandt (poden lukkede sig under hjulet; forkerte dråbehuller). Tilføjede hardwaremodeller (sæt M2–M4), batterimodul (celler + holdere), batteriplade + klemmer i forreste midterbakke, bolteksempler og BOM. Fusion gemt. Billeder i `docs/skelet/v2_*`. Detaljer: PROJECT_OVERVIEW §13 "Skelet v2".
**Issues:** Udseender forsvandt ved genberegning (sæt dem inde i base feature-edit). Låseskruen er fjernet. BOM: 144 M3×12 mod 20 i sættet.
**Next:** Mikkel beslutter hardware (køb flere M3, eller færre bolte pr. samling). Bedre motorlås. Udhule pods. STL + testprint af hjørne + bakke.

## 2026-10-06 (forts.) — Claude Code (Opus 5.5), skelet-chat
**Summary:** Bakkerne er erstattet af en stigeramme efter Mikkels ønske: længdebjælker, 4 tværbjælker, kofangere og LiDAR-mast. Alle samlinger har V-nøgle + bolte. LiDAR-data hentet fra databladet. Batteriet er flyttet op på tværbjælkerne. Alle tjek grønne. Fusion gemt. Billeder: `docs/skelet/v3_*`. Detaljer: PROJECT_OVERVIEW "Skelet v3".
**Issues:** Det første MCP-kald timede ud uden at køre (gentaget OK). V-nøglernes ender pegede nedad i print → rygge løber til toppen, riller ud i bunden.
**Next:** Mikkel vurderer rammen. Derefter: beslag til skallen, sensorholdere i kofangerne, motorlås, udhuling, STL og testprint af én samling (hjørne + bjælkeende).

## 2026-10-06 (forts. 2) — Claude Code (Opus 5.5), skelet-chat
**Summary:** Alle huller er nu runde (ramme, pod, skruetrækkerhul, klemmer). Pod, ramme og batteri er genbygget, alle tjek grønne, Fusion gemt.
**Open:** Mikkel spørger til printede bolte/møtrikker (han har for få M3). Anbefaling: printede M10-bolte og -møtrikker til rammens bjælkesamlinger (1–2 pr. samling sammen med V-nøglen), M3 kun i hjørnerne og ved lejet. Først et gevind-testprint med 3 frigange. Afventer svar.
- 2026-10-06 (forts. 3): Centrerede hulmønstre, kvadrathul i kofangerne, LiDAR-huller rettet. Alle tjek grønne, Fusion gemt. Mikkel overvejer printede bolte: retningen er bekymringen (vandret printede gevind) og alternativet med at skære gevind selv. Afventer svar om, hvilke tap/snitbakke-størrelser han har.
- 2026-10-06 (forts. 4): Diamantkanal gennem kofangere og tværbjælker (x = ±60, verificeret fri). Printede M8-bolte (gevind skæres af Mikkel) i alle bjælkesamlinger, batteri og mast. M3-behovet er nu 40 = hans sæt. Testprint-STL i print/skelet_test. Alle tjek grønne, Fusion gemt.
  **Next:** Mikkel printer testen (V-nøgle + M8-gevind). Derefter justeres `Frame_KeyClear` og `PM8`, og hele rammen eksporteres.
- 2026-10-06 (forts. 5): Body v0 tegnet (50 Shell): facetteret skal med skærm, gitter, hjulkasser og alle sensor-/lyshuller. `BIG`-fejl i halvrums-snit fundet og rettet (ramme genbygget, uændret). Fusion gemt. Billeder: docs/skelet/body_v0_*.png. **Next:** dele skallen i printpaneler + beslag/hurtigkobling til rammen.

## 2026-10-07 — Claude Code (Opus 5.5)
**Summary:** Byggede `components/`: komponentliste med 85 linjer (`inventory.csv` → `INVENTORY.md` + søgbar `index.html` via `build_inventory.py`), 37 datablade hentet til `components/datasheets/` og ESP-01-guide (`components/esp-01/`: pinout, SVG-diagram til Mega, passthrough- og webserver-sketch, begge kompileret med avr-g++ / AVR-core 1.8.8). Pointer i PROJECT_OVERVIEW §4.
**Issues:** ST/TI blokerer curl for nogle PDF'er → hentet fra SparkFun/Adafruit/Pololu-spejle (7805-databladet er TI µA7800). AliExpress-mails har afkortede varenavne (BTS7960 og IRFZ44N ikke bekræftet). Påstanden "WiFi droppet pga. hardwareproblemer" stammer fra en ChatGPT-opsummering af V1, som Mikkel kaldte forkert. Ingen arduino-cli fundet; sketches er kun kompileret, ikke testet på hardware. Mappen er stadig ikke et git-repo.
**Next:** Udfyld priser/RAM for Pi 5 og LiDAR; tilføj V1-dele der stadig findes (resistorer?); evt. test ESP-01 med passthrough-sketchen.

## 2026-10-11 — Claude Code (Opus 5.5)
**Summary:** Helt testhjul eksporteret til `print/testhjul_v3.1/` fra "11 Wheel Lab" (Fusion "SENNEP V2 v27", parametre = generatorens defaults, generatoren uændret siden v18). Nyt: STL'erne er roteret i printorientering (printflade på Z = 0, centreret) med `orient.py` (scratchpad; roterer om Y så valgt ±X-flade vender ned), så "Lay on face" ikke behøves. Kontaktflader verificeret: Rim A 3065, Rim B 2915, aksel 1193, afstandsrør 165, rulle 80 mm².
**Issues:** Ingen notat om hurtigtest-resultatet — ukendt om pasningerne er bekræftet før det fulde hjul. Mappen er stadig ikke et git-repo (intet commit).
**Next:** Mikkel printer hjulet → justér frigange; venstre/højre hjul i drivmodulet.
- (forts.) Hjulkassen også eksporteret til `print/testhjul_v3.1/hjulkasse/` fra "21 Pod Lab": pod (stående på motorenden, +X ned, 169 mm), motorkrave og lejeholder (−X ned). Poden er stadig massiv (562 cm³).

## 2026-10-12 — Claude Code (Opus 5.5)
**Summary:** Mikkel kunne ikke samle hjulet: rullerne falder af Rim A's korte pinde. Lavede en genbrugelig samlering (`fusion/SENNEP_WheelGenerator/assembly_ring.py` → "11 Wheel Lab Assembly Ring (samlering)", to varianter: med/uden TPU-sleeves). Ringen ligger kun ved r ≥ 50 (fælge maks. 49,6) og x ≥ 0,5 (Rim A-siden af samlingen); vuggerne er rullerne (+0,3 mm radialt) swept langs −X, så hjulet kan løftes ud. Tjek: 0 mm³ mod Rim A/B og under løft 0–20 mm; rulle skubbet 0,4 mm ud rammer vuggen. STL + guide i `print/testhjul_v3.1/samlering/`.
**Issues:** Fusion-MCP-connectoren i sessionen genforbandt ikke, selv om Fusion kørte → kaldt direkte via HTTP (127.0.0.1:27182/mcp) med en lille klient (scratchpad `fx.py`). Swept med 75 enkelt-unions timede ud (>10 min); fordobling (7 unions) + én cutter roteret 9× tog ~1 min. Sleeven er et hult rør → skal carves sammen med kernen. Ren radial forskydning efterlod rullens inderflanke → cutteren = rulle i hvile ∪ forskudt rulle. Body-navne sat inde i base-feature-edit går tabt → navngiv efter finishEdit.
**Next:** Mikkel printer ringen og samler hjulet → pasninger (riller, bajonet, sekskant, ruller).
- (forts.) Samleringen har fået materiale PET Plastic + blå mat appearance (71 / 65 g massiv); STL re-eksporteret, Fusion gemt. Resten af hjulets bodies står stadig som Steel (kun appearance er sat).

## 2026-10-12 (forts.) — Claude Code (Opus 5.5)
**Summary:** Mikkel spurgte, hvordan hjul + leje + pod samles, når lejeholderens skruer skal i fra hjulsiden. Tjek i Fusion: en Ø6-korridor ved r = 28 går fri gennem Rim A, Rim B, ruller, afstandsrør og akselhoved for hjulvinkler 16–44° (gentager hver 60°) → skruerne kan spændes gennem vinduerne; **poden skal ikke laves om/genprintes**. Nyt script `fusion/SENNEP_ChassisGenerator/pod_hardware.py` → "22 Pod Lab Hardware" (2× M3×19+skive+indsats, 4× M4×12+skive, M3×12+møtrik i koblingen) og "23 Pod Lab Samletrin" (skjult: hjul drejet −30° + 2 nøgler). Alle tjek fri (hardware mod plast, pinolskrue drejet 360°, nøgler gennem vinduer). Samlevejledning i `print/testhjul_v3.1/LÆS MIG.md`, billeder `hjulkasse/samling_*.png`.
**Findings:** Koblingsskruen M3×12 skal skrues helt i bund før hjulet skubbes ind (hoved r 11,4 går fri; kun i møtrikken r 20,1 rammer poden), og skrues ~7 mm ud gennem tophullet, før motoren sættes i. M3×12 er kortest i sættet; en kort pinolskrue (M3×5–6) ville være bedre.
**Rejected:** Mikkels idé om lange skruer bagfra: med BoltAngle 0 ligger boltlinjen (y = ±28, z = 0) oven i krave-tappernes kanaler; kræver BoltAngle ≈ 19,5° + styrerør og et nyt print. Unødvendigt, når vinduerne virker.

## 2026-10-12 (forts. 2) — Claude Code (Opus 5.5)
**Summary:** Mikkel ødelagde v1-housingen (boring bagfra) og fandt vindues-metoden for besværlig. "Pod" hedder nu **housing** over for Mikkel. Housing v2 i chassisgeneratoren: lejeholder-skruer bagfra (M3×19+skive, hoved i forsænkning Ø7,6 i lommebunden, 6 mm bund; indsatser i holderens forside; Ø10 værktøjskanal ud gennem motorenden, fri af motoren), pinolskrue nås nedefra (Ø12, `Chassis_ToolDia`), `Chassis_MotorClear` 0,2→0,1, krave-tapper roteret til 90° (`Chassis_LugAngle`) fordi tapkanalerne lå på skruelinjen. Hul variant (`make_hollow`, "21 Pod Lab (hul variant)") — estimeret ~5 g MERE filament (241 vs 236 g ved 3 vægge/15 %), da kammerets vægge printes massivt. `pod_hardware.py` opdateret ("22 Pod Lab Hardware", "23 Pod Lab Skruetraekkere bagfra"). STL i `print/housing_v2/`.
**Issues:** MCP-kald over HTTP timede ud på klientsiden, selv om Fusion gennemførte kaldet (hardware-scriptet) → verificér tilstanden bagefter i stedet for at stole på timeouts. Mikkel så "fejl i Fusion" — sandsynligvis de afbrudte kald; geometrien er verificeret (cylinderradier 3,8/5,0/6,0/21,3 i housing-bodyen). Samleringen talte som kollision i `display_bodies` → filtreret fra.
**Not done:** "20 Chassis" er ikke genbygget med housing v2 (4 hjørner + hardware i "91 Hardware (placed)" bruger stadig gammel lejeholder-placering i build_chassis linje ~1066). Virkelig filamentbesparelse kræver mindre ydre volumen (fx 45°-kilen under motorrøret).

## 2026-10-12 (forts. 3) — Claude Code (Opus 5.5)
**Summary:** Projektet er nu et git-repo (lokalt, `main`, ikke pushet endnu; `.gitignore` udelader node_modules/.next/.env). Seks opgave-chips oprettet til separate sessioner, alle med "status → research → plan → AskUserQuestion med Mikkel → først derefter byg": ny LiDAR-stack fra bunden (den gamle Gemini-app kun som inspiration), Pi↔Mega-link, breadboard-kredsløb, PCB (først efter breadboard), dokumentation + komplet komponentliste (inkl. dele fra andre projekter), 3S6P-batteriet med eksisterende materialer.
**Note:** Fusion kan ikke nås fra cloud-sessioner (MCP kører på 127.0.0.1:27182); en tunnel frarådes (fjernkørsel af vilkårlig Python uden auth).
- (forts.) Offentligt repo: https://github.com/MikkelBlom/SENNEP-V2 (HTTPS). Før push: fakturaer, Gemini-PDF'er, `gpttxt.txt` og `botnroll.txt` holdes lokalt (`.gitignore`: `/*.pdf` i roden), hjemadresse og ordrenumre fjernet fra noter og `inventory.csv` (kolonnen `ordre` er tømt), historikken squashet til ét rent commit. Git-identitet bruger GitHub-noreply-mail. Datablade (90 MB, producenternes PDF'er) ligger i repoet.
- (forts.) Chips genskabt efter GitHub-remote blev sat op (de gamle sagde 'no github remote'). Køen holder maks. 5 chips: LiDAR, Pi↔Mega, breadboard, docs+komponentliste, batteri. **PCB-chippen skal genskabes**, når breadboard-planen (`docs/electronics/BREADBOARD_PLAN.md`) er aftalt.

## 2026-10-12 (cont. 4) — Claude Code (Opus 5.5), docs + parts list (cloud)
**Summary:** Docs restructured with Mikkel (choices in `docs/DOCS_PLAN.md`). New root `CLAUDE.md`, `ai-instructions/INDEX.md`, `FEATURES.md`, `WORKING_NOTES.md` (18 open concerns + decisions with reasoning), `FUTURE_IDEAS.md`, plus English `docs/` (README, requirements, wheel, chassis, motor-and-power, printing-lessons, fusion-scripting, history). `PROJECT_OVERVIEW.md` and `HANDOFF_CHASSIS.md` archived unchanged in `ai-instructions/archive/`. `Cut noter.txt` embedded verbatim in `docs/history.md`. Parts list translated to English with new `source` + `condition` columns. `secrets.h` added to `.gitignore`. From now on, notes are written in English.
**Decisions:** All English. Contradictions are flagged in WORKING_NOTES, not resolved: a full consolidation session comes later. The main MCU link is Pi ↔ Mega (the Nano is also used).
**Issues:** The global CLAUDE.md is not available in cloud containers, so the task text was followed. Gmail needed re-authentication, so the Pi 5 / LiDAR prices could not be looked up. Pi 5 RAM is 4 or 8 GB per Mikkel (unconfirmed).
**Next:** Full consolidation session: physical count of every part (qty, source, condition), resolve WORKING_NOTES C1–C18, fill the Pi 5 / LiDAR gaps.

## 2026-10-12 (forts. 4) — Claude Code (Opus 5.5), Pi↔Mega-link
**Summary:** Research + `docs/electronics/PI_MEGA_LINK.md` (USB vs GPIO-UART vs I²C/SPI; COBS+CRC-16 vs MAVLink/Firmata/micro-ROS; latenskæde; én Mega vs Nano-noder; udvidelsesplan). Tre runder med Mikkel: GPIO-UART via BSS138 (250 kbaud), ESP-01 droppet, reset-ledning fra Pi, én Mega-hub + LED-Nano på Serial3, sikkerhedsregler godkendt (ARM, 200 ms watchdog, lokal kant/ToF-blokering). Kode: `protocol/messages.json` → `tools/gen_msgs.py` (C-header, Python, MESSAGES.md), portabel C99-kerne `firmware/libraries/SennepProto` (COBS/CRC/stream-decoder + sikkerhedslogik), Mega-sketch `firmware/sennep_mega` (20 kHz PWM, I²C-drivere, node-relay), `tests/test_core.c` (12.071 checks grønne, ASan/UBSan). Build: `tools/build_mega.sh --avr-gcc` (apt gcc-avr + arduino-core-avr 1.8.6; downloads.arduino.cc er blokeret i cloud).
**Issues:** Mikkel besluttede midt i sessionen "fuld Rust" → Pi-siden bliver Rust, Python-værktøjet erstattes af Rust-CLI. Uafklaret om Megaen også skal være Rust (Mikkel bad om forklaring). Inventory: Mikkel siger 1 Mega + flere Uno; `inventory.csv` siger 2 Mega, 0 Uno. INA219-modulets 0,1 Ω-shunt kan kun måle ~3,2 A → motorstrøm kræver ekstern shunt [kredsløb]. Intet testet på hardware.
**Next:** Mikkels svar om Mega-sprog → Rust-crate (`sennep-proto` no_std + `sennep-link` + CLI), evt. port af Mega-firmware. Kredsløbsopgaven skal bruge pin-udkastet i `firmware/sennep_mega/config.h`.
- (forts.) Samlet plan til konsolidering: `ai-instructions/PLAN_PI_MEGA_LINK.md` (beslutninger, status, åbne spørgsmål, faser, hardware-testliste, krav til kredsløbsopgaven).
## 2026-10-12 — Claude Code (Opus 5.5), LiDAR-stack v2 (cloud-session, branch `claude/fervent-tesla-tbrtpz`)
**Summary:** Status → research → plan (`docs/lidar/PLAN.md`) → 2 runder spørgsmål → bygget. Mikkels valg: **Rust** (ikke Python; Pi'en skal også køre kamera/AI), forhindringer først, zoner sendes til Megaen, UI i browser + 7" skærm, LiDAR via USB-adapteren. Bygget `lidar/`: LD19-parser (testet mod manualens eksempelpakke), ur-synk, scan-samling på punkt-niveau, filtre, sikkerhedszoner pr. pakke, LiDAR-odometri (de-skew + punkt-til-linje ICP mod keyframes nær robotten), log-odds-kort, HTTP/WebSocket-UI, simulator der laver rå LD19-bytes, `bench`. 17 tests grønne. Tal: ~3 % af én kerne, ~6 MB RAM, statisk jitter < 1 mm, 0,02 % drift på en 8,7 m tur, tilbage ved start med 2,6 mm fejl efter 173 m. Statisk ARM64-binær bygges med `--target aarch64-unknown-linux-musl` (verificeret under qemu: identiske resultater).
**Findings:** Den gamle app hakkede pga. software, ikke sensoren (1,5 mm støj): sweeps skåret på pakkegrænser (492/504 punkter, overlap ved sømmen), ingen tidsstempler, kortet ignorerede positionen, ICP frame-til-frame uden startgæt, EMA-lag oven på hinanden, sandsynlig spejlvending (LD19 tæller med uret). Optagelserne er alle statiske (LiDAR på et bord) → simulatoren er nødvendig for at teste kørsel.
**Issues:** Intet kørt på rigtig LiDAR/Pi (cloud). Pi-tal er estimater; Mikkel skal køre `bench` på Pi'en. Kiosk-autostart på 7" skærm ikke sat op. `pkill -f <mønster>` i samme kommando dræber egen shell — brug `[s]ennep`-tricket.
**Handoff:** fuld kontekst (Mikkels svar ordret, beslutninger, antagelser, næste skridt) i `ai-instructions/HANDOFF_LIDAR.md`.
**Next:** Kør på Pi'en med rigtig LiDAR + `--record` nogle ture; tjek LiDAR'ens 0°-retning og robotomrids; integrér `ZoneReport` i Pi↔Mega-linket; gyro i odometrien; gem/indlæs kort.

## 2026-10-12 — Claude Code (Opus 5.5), elektronik/breadboard-chat
**Summary:** Plan v0.2 i `docs/electronics/BREADBOARD_PLAN.md`: status over alle elektriske dele, effektbudget, ledningstværsnit/sikringer, stjernestel og støj, nødstop via relæspolen (fejlsikker, ingen automatisk genstart), pinfordeling for Mega + Pi 5, blokdiagram, indkøb (minimum ~190 kr / anbefalet ~900–1200 kr) og testrækkefølge for M1 (Pi + Mega + 4 motorer + LiDAR). To runder spørgsmål til Mikkel.
**Decisions:** M1 = Pi, Mega, 4 motorer med hjul, LiDAR. Wago/skrue til strøm, breadboard til signaler. Pi↔Mega fysisk og sensorfordeling ejes af andre sessioner (mine forslag står i planen). Budget fastlægges ved konsolideringen.
**Findings:** Testbatteriet er en Zippy 1000 mAh 3S 35C LiPo uden BMS (samme der ødelagde V1) → 20 A-sikring ved XT60, LiPo-alarm, bænk-tilstand med logik på 12 V-adapter og kun motorer på LiPo (fælles GND). INA219's 0,1 Ω shunt kan kun 3,2 A. Motorens stallstrøm står ikke i databladet (estimat 15–25 A, måles). PI_MEGA_LINK.md fandtes ikke ved sessionens start.
**Handoff:** `ai-instructions/HANDOFF_ELECTRONICS.md` (alle svar fra Mikkel, beslutninger, fund).
**Next:** Fælles konsolideringssession → godkend planen → ledningsdiagrammer (SVG/KiCad) og detaljeret byggevejledning pr. trin.

## 2026-10-12 (forts. 4) — Claude Code (Opus 5.5), batteri-chat
**Summary:** Batteriplan påbegyndt: `docs/electronics/BATTERY_PLAN.md` (udkast v2). Afklaret med Mikkel: cellerne er **nye og kun klikset i plastholdere — ingen forbindelser overhovedet** (også P-grupperne mangler; noterne sagde andet). Værktøj: Fluke 83, 48 W loddestation (for svag til lodning på celler), ingen svejser/crimptang. Nikkelstrip findes, men i for små stykker. Bilsikringskasse har måske holdere. Ingen lange bolte. Mikkel valgte punktsvejsning hos værksted i Odense → kandidat: Fyns Batteri Service (Knullen 8, Odense S, ikke verificeret — sitet var blokeret fra containeren). Planen har målevejledning for cellerne (§6), layout med 4 strips (§4), BMS-ledninger (§5), sikringer, ladning, indkøb. Nikkelstrip tilføjet i inventory.
**Findings:** Motorens stall-strøm er ikke opgivet (RS-datablad "5,5 mA" = fejl); estimat ~5,7 A ved mærkelast, stall ukendt → mål viklingsmodstand. INA219-modulets 0,1 Ω-shunt tåler kun ~3,2 A → ikke i motorstrømmen.
**Next:** Mikkel måler 20 celler (§6) og sender tallene → Claude fordeler i 3 grupper. Ringer til værksted. Foto af BMS + find blade-holdere. Derefter endelig illustreret guide (kun efter godkendelse).
- (forts.) Fuld kontekst til konsolidering (Mikkels svar ordret, beslutninger, åbne punkter, kilder): `ai-instructions/HANDOFF_BATTERY.md`. Branch: `claude/nifty-faraday-doit7x`.

## 2026-10-12 (forts. 4) — Claude Code (Opus 5.5), PCB-chat
**Summary:** PCB-opgaven er stoppet ved forudsætningstjekket: `docs/electronics/` og `BREADBOARD_PLAN.md` findes ikke på nogen branch, og der er ingen aftalt breadboard-opstilling. Intet PCB-arbejde lavet.
**Next:** Kør breadboard-opgaven først (plan → aftale med Mikkel → bygget og testet). Start derefter PCB-chatten igen.
- Kontekst til konsolidering: PCB-opgavens mål var et carrier/shield-board (Mega + stik til Pi 5, motordrivere, sensorer, strømfordeling, sikringer, nødstop) i KiCad, klar til JLCPCB/PCBWay eller fræsning/håndbygning. Rækkefølge: status (breadboard-skema, testerfaringer, pladsmål fra Fusion — spørg Mikkel, da Fusion ikke kan nås fra cloud) → research (shield vs. separate boards, motorstrøm på/af boardet, JST-XH/skrueterminaler, polaritet/TVS/sikringer, fab-regler/pris, montage) → `docs/electronics/PCB_PLAN.md` → AskUserQuestion (fab vs. DIY, SMD vs. THT, budget, størrelse, hvad skal kunne skiftes) → først efter godkendelse: KiCad-skema/layout, ERC/DRC, gerbers + BOM + samlevejledning. Mikkel kan i mellemtiden måle boardets maks. størrelse, monteringshuller og kabeludgange. Ingen spørgsmål blev besvaret af Mikkel i denne session.

## 2026-10-12 (cont. 5) — Claude Code, consolidation of the 6 cloud sessions
**Summary:** Merged all six branches (docs, battery, breadboard, Pi↔Mega link, LiDAR v2, PCB) into `main` and deleted them. `PROJECT_OVERVIEW` edits from other sessions were moved out of the frozen archive into `WORKING_NOTES`/`FEATURES`. Inventory rows from the battery session ported to the English schema; new `counted` column; 15 known-but-missing tools/leftovers added (incl. CP2102, Zippy LiPo, Fluke 83). Battery, breadboard, link and LiDAR docs translated to English (incl. `bench.rs` output). The breadboard plan was reconciled with the link plan (GPIO UART, ESP-01 dropped, LiDAR on USB, pin map = `config.h`, A4 bus sense + pin 29 arm button reserved). Handoffs + DOCS_PLAN archived. New `hub/` (local HTML over CSV/Markdown; tested in Chromium). Tests: C core 12 071 checks, LiDAR 17 tests, generator `--check`, all green.
**Decisions:** Battery plan v2 and breadboard plan v0.2 approved by Mikkel. Translate everything to English. Hub saves through Chrome folder access.
**Open:** Q1 Arduino C++ vs Rust on the Mega (Mikkel reads the explanation first). Pi 5 RAM. Physical parts count (in the hub). C19–C23 in WORKING_NOTES.
**Next:** Mikkel measures the 20 cells and calls the workshop; Claude makes the M1 wiring diagrams + build guide.
- 2026-10-12 (cont. 5b): Mega language decided (Arduino C++ + IDE). Battery orientation fixed (black mark front-left; rows G1/G2/G3 front → back) and an interactive battery diagram added to the hub (top/bottom view, strip layer). Mikkel measured all 20 cells: 3.534–3.536 V, all wraps OK; group means equal within 0.001 V, so no cells need moving. **Next:** measure strip/holder pitch, call the welding shop, fuse holders, BMS photo, motor winding resistance.
- 2026-10-12 (cont. 5c): LiDAR tested live on Mikkel's PC (Windows build). From his recording (`lidar/recordings/2026-10-12_room_walkthrough.ldr`): walls as stable straight lines fitted to the map (`walls.rs`), objects as outlines, moving-thing tracking with speed, trail, 1 s prediction and 2 s "lost" guessing (`motion.rs`); UI in English with layer buttons. 26 tests green (incl. 0 ghost movers while driving in the simulator, the real walker tracked 80/80 with one id). Motor stall ~7–8 A measured; fuse rows cleaned up. **Next:** more recordings, LiDAR on the Pi, Mega link.
- 2026-10-12 (cont. 5d): Second recording analysed (`room_2`: stand still, 3 sprints at peak ~3.5 m/s / 12–13 km/h, bending down). Tracker made agile (faster acceleration, speed-scaled gate, slowing + bounded coasting, re-acquire by id) → one id for the whole 80 s. Recording moved into the page: auto-records a live LiDAR into `lidar/recordings/auto/` (git-ignored), Keep / Mark / Stop / Start buttons. 30 tests green.
- 2026-10-12 (cont. 5e): Third recording (`room_3`): Mikkel was split into ids 10/74 and id 129 sat on his glass kettle. Fixed (10 s memory, ≥ 6-point confirmation, flicker learning, satellites) → one id for the whole visit. Added playback to the page (Recordings list, play/pause/jump/speed/marks, back to live) and `sync.cmd` (pull + commit + push). 36 tests green.
- 2026-10-12 (cont. 5f): Playback bug (Mikkel had to press New map after jumping/switching): every recording has its own timestamps and only the map was reset, so the sensor clock and scan assembly got stuck. Now `Pipeline::reset_all` on play/switch/jump/live; two tests. room_3 notes completed with Mikkel's answers (wall at 1:21, his arm at 2:43, hands over the LiDAR at 2:12–2:17: pose held within 6 mm, map untouched).
- 2026-10-12 (end): Session closed by Mikkel. Full handoff in `ai-instructions/HANDOFF_NEXT.md`; `CLAUDE.md` compute/status lines updated (Rust on the Pi, Arduino C++ on the Mega, LiDAR stack running).

## 2026-10-13 — Claude Code (Opus 5.5)
**Summary:** Universelle stel-dele: én skinne (×4) og én halv tværbjælke (×4/×8) i stedet for 6 varianter. Midtersamlinger: V-rille i begge dele + løs nøglestang (`key_bar`, 30 mm, vandret mellem boltrækkerne). Skinnerne har krydsbjælke-riller/huller i begge vægge og en centreret vandret nøgle mod housingen, så de er symmetriske (verificeret: 0,00 mm³ forskel mellem alle skinner/halvdele og drejede kopier af den første). Printede M8 har nu flange på hoved og møtrik (ingen skiver), L 26→22. Hele "20 Chassis" genbygget med housing v2: ingen kollisioner, intet overhang, bolte fri. Minimum-printsæt i `print/chassis_v1/` via nyt `chassis_print.py` ("94 Chassis Print (minimum)", skjult).
**Issues:** Første forsøg havde rillerne vendt forkert i front-/venstredelene og nøglen lodret gennem boltene i tværbjælken — fanget af kollisionstjekket. HTTP-klienten timer ud på lange builds; Fusion skriver nu loggen til en fil i scratchpad.
**Open:** Plastmængden er stor (skinner 203 cm³, halve tværbjælker 121 cm³ massivt; 6 mm vægge). Kofangerne har stadig ryg/rille-par (ikke universelle). `build_test_print` og "90 Hardware" viser stadig de gamle løse M8-skiver.

## 2026-10-15 — Claude Code (Opus 5.5)
**Summary:** Mikkel printede 4 ens hjul; to skal være spejlvendte. Spejlede STL'er direkte (x → −x i printframe, vindingsorden byttet, samme fortegn på volumen som originalen) i `print/testhjul_v3.1/spejlvendt/`: Rim A, Rim B, afstandsrør og samleringen. Afstandsrøret og samleringen er håndede (symmetritest på meshet: bedste spejlplan afviger 3,6 / 5,4 mm), derfor også de. Ruller, sleeves, aksel og housing er uændrede. Fusion var ikke forbundet; generatoren har stadig ikke en `HAND`-parameter (FEATURES: Left/right-handed wheels).
**Open:** Hvilke hjørner der får hvilken hånd (X-mønster set oppefra) er ikke tegnet i Fusion.
- (forts.) Rettelse: det originale afstandsrør virker i den spejlvendte Rim A (Fusion: lige ind ved 0° fri, drej −60° fri hele vejen, låst ved −60° = trukket ud blokeret, sekskant flugter). Spejlet afstandsrør slettet.

## 2026-10-15 (cont.) — Claude Code (Opus 5.5), AlmaOS side project
**Summary:** Mikkel started a separate project, **AlmaOS** (working name): an open-source HAOS-style Pi appliance OS with a web desktop, typed hardware capabilities, sandboxed connectors/apps from a store, bench tools and robot safety primitives. SENNEP V2 is its first app and reference machine. Design docs only, in `../AlmaOS/` (renamed **Faber**, now `../Faber/`, same day) (sibling folder, not a git repo yet; its own log is `AlmaOS/ai-instructions/SESSIONS.md`). Nothing in SENNEP changed except this entry.
**Relevance for SENNEP:** AlmaOS plans to generalise SENNEP's Pi ↔ Mega protocol (`protocol/`) into "AlmaLink" and reuse the LD19 parser from `lidar/` as its first connector. No SENNEP code depends on AlmaOS.

## 2026-10-17 — Claude Code (Opus 5.5), the Pi 5 arrives
**Summary:** Mikkel flashed Raspberry Pi OS 64-bit (trixie) with Imager: hostname `sennep`, user `sennep`, Wi-Fi, SSH key only (`id_ed25519`, passphrase held by the Windows ssh-agent, so use `C:\Windows\System32\OpenSSH\ssh.exe`, not Git Bash's ssh). Pi 5 **4 GB**. Passwordless sudo via `/etc/sudoers.d/zz-sennep-nopasswd` (the `010_` name lost to a later rule). Desktop autologin on. Faber's `tools/pi/deploy.sh --setup` installed build tools + Rust, turned on I²C/SPI/UART (`/dev/i2c-1`, `/dev/spidev0.*`, `/dev/serial0` present after reboot) and runs `faber-core` as a service on :7878. `lidar/` built on the Pi (33 s), 36/36 tests green there, installed as `sennep-lidar` with a `StateDirectory` (it couldn't write recordings in `/`). LiDAR on USB (CP2102 by-id name matches the unit). Benchmark: `docs/lidar/BENCHMARK-pi.md`, ~4 % of one core, < 10 ms per revolution.
**Issues:** Windows ssh.exe can't read a Git Bash pipe (deploy now uses scp). `.local` names don't resolve in Chrome on his PC; the IP (192.168.0.106) does.
**Open:** The service runs without `--no-body` (robot outline masked); if the LiDAR is still loose on a desk, near things are hidden. Kiosk on the 7" screen not set up. Faber admin not created yet (Mikkel picks the password at http://192.168.0.106:7878).
- 2026-10-17 (cont.): Mikkel added the LiDAR as a part in Faber, and it failed with "busy" because `sennep-lidar` held `/dev/ttyUSB0`. `sennep-lidar` is now **stopped and disabled**, and Faber owns the LiDAR. To switch back: `sudo systemctl disable --now faber-core` is NOT the way (Faber runs everything); instead remove the part in Faber and `sudo systemctl enable --now sennep-lidar`.
- 2026-10-17 (cont.): SENNEP V2's whole electronics are now a drawing in Faber's **Circuits** (Faber repo, `docs/circuits.md`; Add ▾ → Example: SENNEP V2): 66 parts and 203 wires from `docs/electronics/BREADBOARD_PLAN.md` + `config.h`, with the plan's wire gauges (10 AWG battery path, 16 AWG bus and logic branch, Dupont signals). It passes every check, and power mode reproduces the plan's numbers: with all four motors held still (estimated 20 A each, not measured) ~67 A blows the 30 A main fuse; the e-stop drops the relay and the A4 divider reads 0 V. Guesses in it (not in the plan): the LED strip (2 m, 60 LEDs, own 5 A buck), the Nano LED node on D0/D1. Left out: the e-stop's second contact to D23 (contacts not measured, §8.4), RESET via the shifter, L_IS.

## 2026-10-18 — Claude Code (Opus 5.5), where we stand (grilling)
**Summary:** Status → three rounds of questions with Mikkel. Installed Matt Pocock's skills in the repo (`.agents/skills`, `.claude/skills`, `skills-lock.json`; the installer ignored `--skill=grill-me` and added all 38; Mikkel keeps them). Answers and decisions in WORKING_NOTES (2026-10-18 rows, C24–C25) and HANDOFF_NEXT ("Update 2026-10-18"). Priced on AliExpress (to Denmark, today): M5 nyloc 304 ≈ 0.41 kr/pc, M5 DIN912 ≈ 0.05–0.30 kr/pc, black V-slot cut to length 2020/400 mm 52 kr and 2040/450 mm 89 kr, 2020 connector set ~47 kr, spot welders AWithZ 190 kr (90-gear) / 345 kr (9000 W pedal), FNIRSI 652 kr; Loctite 243 109 kr (Pricerunner). All in hub Shopping s18–s25. Drafted the mail to Fyns Batteri Service (Mikkel sent it). Breadboard plan status corrected to "not reviewed". Faber: motor stall in Circuits 20 A → 8 A (computed from the measured winding).
**Findings:** The AI Camera was in `inventory.csv` all along (`pi-ai-camera`), just never mentioned. Faber already has a SENNEP app (`examples/apps/sennep`: LiDAR top view, safe driving, pose) and an app system (wasm logic + sandboxed UI, 20 Hz subscriptions, 4 KB messages). `lidar/`'s algorithms (walls, objects, tracking) are std-only Rust and could run in an app's wasm logic; its recordings/playback need files, which apps can't have. Faber's `camera@1` is designed but no camera connector exists. AliExpress search pages only partly render without login (some show only ads).
**Next:** Workshop's answer → weld or buy the welder. Mikkel decides on the profile frame (~450 kr). The LiDAR app (t30) and the camera (t31) when he wants to work on software.

## 2026-11-06 — Claude Code (Opus 5.5), disk cleanup
**Summary:** No git worktrees besides `main` (no `.claude/worktrees`; seven `origin/claude/*` branches exist only on the remote, not checked out locally). Deleted the only regenerable build output: `Lidar Test Enviornment/.next` (97 MB, git-ignored; `npm run build`/`dev` recreates it). Project 389 MB → 293 MB. No `target/`, `node_modules`, `__pycache__` or test output found (`lidar/` is built on the Pi, so there is no local `target/`).
**Left alone:** `sennep-lidar.exe` (6.7 MB, ignored; a built binary but maybe used), `Lidar Test Enviornment/build.log` (1 KB), `Samtale.pdf` (13.6 MB, ignored chat export), datasheets, recordings, `print/` 3MFs, `.git` (127 MB).
