MikkelBlom/SENNEP-V2/ai-instructions/FUTURE_IDEAS.md

# Future ideas

Moved to the hub on 2026-10-12: `hub/data/ideas.csv` (Ideas tab in `hub/index.html`).
