MikkelBlom/SENNEP-V2/docs/skelet/v1_pod_printretning.png

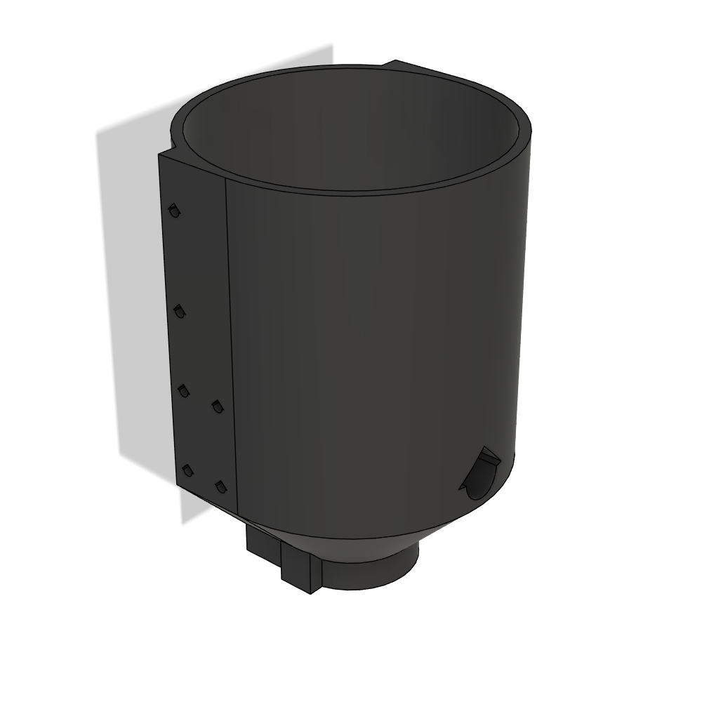
docs/skelet/v1_pod_printretning.png
