MikkelBlom/SENNEP-V2/print/housing_v2/1_bund_og_bagende.png

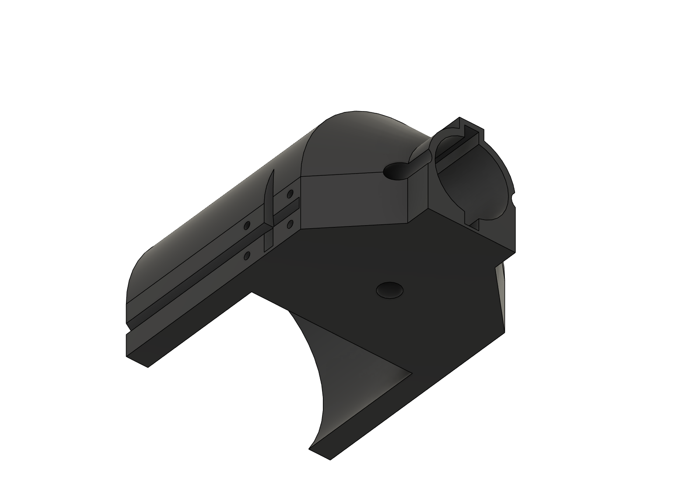
print/housing_v2/1_bund_og_bagende.png
