MikkelBlom/SENNEP-V2/print/housing_v2/2_bagende_vaerktoejskanaler.png

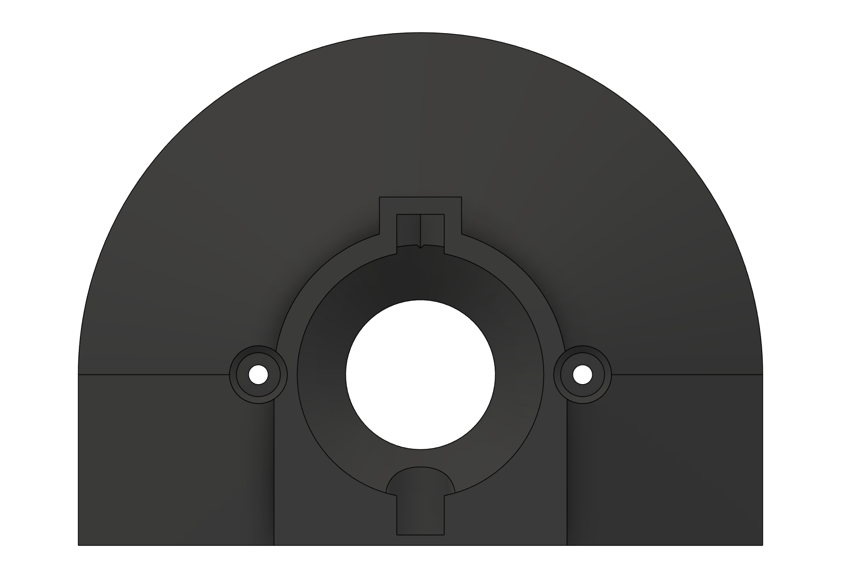
print/housing_v2/2_bagende_vaerktoejskanaler.png
