MikkelBlom/SENNEP-V2/print/housing_v2/3_gennemsigtig_med_skruer.png

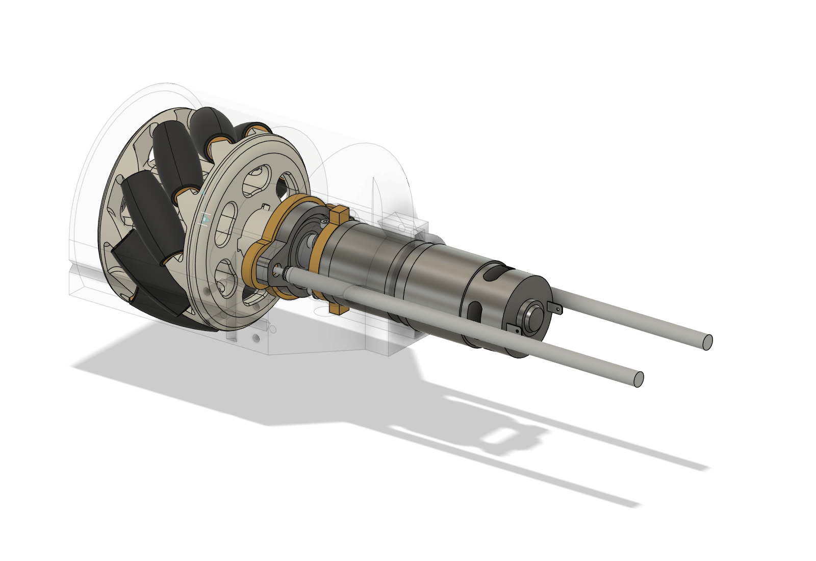
print/housing_v2/3_gennemsigtig_med_skruer.png
