MikkelBlom/SENNEP-V2/docs/lidar/BENCHMARK-pi.md

# LiDAR stack v2 — benchmark

Machine: Raspberry Pi 5 Model B Rev 1.0 (aarch64), 4 cores. Build: release. Generated by `cargo run --release --bin bench`.

All sources are replayed as fast as possible; only the pipeline (parser → zones → scan assembly → filter → odometry → map) is timed.
*CPU* = CPU time / data duration, i.e. how large a share of one core the stack uses in real time.
*Per packet* = parser + zone update for 12 points (what the safety zones wait for). *Per revolution* = filter + odometry + map, after the revolution's last point.

## Performance

| Scenario | Data | Revs | Packets | CPU (1 core) | Per packet µs (median/p99/max) | Per revolution ms (median/p99/max) | ΔRAM |
|---|---:|---:|---:|---:|---:|---:|---:|
| Recording 2026-04-10T02-26-33 | 4.7 s | 46 | 1955 | 3.0 % | 0 / 1 / 8 | 2.63 / 8.30 / 8.30 | 0.8 MB |
| Recording 2026-04-10T12-28-47 | 2.6 s | 25 | 1081 | 2.7 % | 0 / 1 / 2 | 2.64 / 3.03 / 3.03 | 0.8 MB |
| Recording 2026-04-10T13-22-13 | 4.9 s | 48 | 2038 | 2.7 % | 0 / 1 / 4 | 2.67 / 5.90 / 5.90 | 6.5 MB |
| Sim: standing still 30 s | 30.0 s | 299 | 12500 | 1.5 % | 0 / 0 / 4 | 1.34 / 2.70 / 3.20 | 0.4 MB |
| Sim: trip 8.7 m | 32.0 s | 319 | 13333 | 3.6 % | 0 / 0 / 6 | 3.08 / 8.00 / 8.12 | 4.0 MB |
| Sim: trip + person + noise on the wire | 32.0 s | 319 | 13266 (66 CRC errors) | 3.4 % | 0 / 1 / 4 | 3.06 / 7.13 / 7.40 | 0.0 MB |
| Sim: trip there and back | 64.0 s | 639 | 26666 | 3.8 % | 0 / 1 / 5 | 3.33 / 7.66 / 8.20 | 0.0 MB |
| Sim: 10 trips there and back | 640.0 s | 6399 | 266666 | 3.9 % | 0 / 1 / 15 | 3.38 / 7.65 / 8.51 | 0.0 MB |

## Stability when the robot stands still

| Scenario | STD x | STD y | STD heading |
|---|---:|---:|---:|
| Recording 2026-04-10T02-26-33 | 0.25 mm | 0.36 mm | 0.080° |
| Recording 2026-04-10T12-28-47 | 0.29 mm | 0.68 mm | 0.090° |
| Recording 2026-04-10T13-22-13 | 0.43 mm | 0.41 mm | 0.071° |
| Sim: standing still 30 s | 1.39 mm | 1.05 mm | 0.039° |

## Odometry and map against the simulator's ground truth

| Scenario | Driven | Matches accepted | ATE (RMS) | Final error | Final heading error | Map precision | Map coverage |
|---|---:|---:|---:|---:|---:|---:|---:|
| Sim: standing still 30 s | 0.0 m | 100.0 % | 2.9 mm | 3.2 mm | 0.00° | 100.0 % | 100.0 % |
| Sim: trip 8.7 m | 8.7 m | 100.0 % | 8.5 mm | 1.7 mm (0.02 %) | 0.18° | 99.2 % | 98.4 % |
| Sim: trip + person + noise on the wire | 8.7 m | 100.0 % | 9.8 mm | 4.2 mm (0.05 %) | 0.04° | 99.4 % | 98.1 % |
| Sim: trip there and back | 17.3 m | 100.0 % | 11.9 mm | 6.8 mm (0.04 %) | 0.10° | 98.2 % | 98.5 % |
| Sim: 10 trips there and back | 173.5 m | 100.0 % | 11.0 mm | 2.6 mm (0.00 %) | 0.01° | 92.6 % | 98.4 % |

Map precision = share of occupied cells less than 10 cm from a real wall. Map coverage = share of the seen walls that are in the map.
