MikkelBlom/SENNEP-V2/docs/lidar/BENCHMARK.md

# LiDAR stack v2 — benchmark

Machine: Intel(R) Xeon(R) Processor @ 2.80GHz (x86_64), 4 cores. Build: release. Generated by `cargo run --release --bin bench`.

> **Not measured on the Pi.** The Pi 5 (Cortex-A76) is expected to be about 1.5–2.5× slower per core than this machine. Run `bench` on the Pi for the real numbers (see `lidar/README.md`).

All sources are replayed as fast as possible; only the pipeline (parser → zones → scan assembly → filter → odometry → map) is timed.
*CPU* = CPU time / data duration, i.e. how large a share of one core the stack uses in real time.
*Per packet* = parser + zone update for 12 points (what the safety zones wait for). *Per revolution* = filter + odometry + map, after the revolution's last point.

## Performance

| Scenario | Data | Revs | Packets | CPU (1 core) | Per packet µs (median/p99/max) | Per revolution ms (median/p99/max) | ΔRAM |
|---|---:|---:|---:|---:|---:|---:|---:|
| Recording 2026-04-10T02-26-33 | 4.7 s | 46 | 1955 | 2.6 % | 0 / 2 / 24 | 2.38 / 6.57 / 6.57 | 0.5 MB |
| Recording 2026-04-10T12-28-47 | 2.6 s | 25 | 1081 | 1.9 % | 0 / 2 / 50 | 2.15 / 3.21 / 3.21 | 0.6 MB |
| Recording 2026-04-10T13-22-13 | 4.9 s | 48 | 2038 | 2.7 % | 0 / 3 / 39 | 2.52 / 6.23 / 6.23 | 6.6 MB |
| Sim: standing still 30 s | 30.0 s | 299 | 12500 | 1.5 % | 0 / 2 / 79 | 1.25 / 2.54 / 3.71 | 0.4 MB |
| Sim: trip 8.7 m | 32.0 s | 319 | 13333 | 4.3 % | 0 / 3 / 536 | 3.86 / 9.70 / 11.28 | 3.8 MB |
| Sim: trip + person + noise on the wire | 32.0 s | 319 | 13266 (66 CRC errors) | 4.1 % | 0 / 4 / 367 | 3.77 / 7.51 / 10.50 | 0.0 MB |
| Sim: trip there and back | 64.0 s | 639 | 26666 | 3.7 % | 0 / 3 / 1694 | 3.30 / 8.22 / 8.72 | 0.0 MB |

## Stability when the robot stands still

| Scenario | STD x | STD y | STD heading |
|---|---:|---:|---:|
| Recording 2026-04-10T02-26-33 | 0.25 mm | 0.36 mm | 0.080° |
| Recording 2026-04-10T12-28-47 | 0.29 mm | 0.68 mm | 0.090° |
| Recording 2026-04-10T13-22-13 | 0.43 mm | 0.41 mm | 0.071° |
| Sim: standing still 30 s | 1.39 mm | 1.05 mm | 0.039° |

## Odometry and map against the simulator's ground truth

| Scenario | Driven | Matches accepted | ATE (RMS) | Final error | Final heading error | Map precision | Map coverage |
|---|---:|---:|---:|---:|---:|---:|---:|
| Sim: standing still 30 s | 0.0 m | 100.0 % | 2.9 mm | 3.2 mm | 0.00° | 100.0 % | 100.0 % |
| Sim: trip 8.7 m | 8.7 m | 100.0 % | 8.5 mm | 1.7 mm (0.02 %) | 0.18° | 99.2 % | 98.4 % |
| Sim: trip + person + noise on the wire | 8.7 m | 100.0 % | 9.8 mm | 4.2 mm (0.05 %) | 0.04° | 99.4 % | 98.1 % |
| Sim: trip there and back | 17.3 m | 100.0 % | 11.9 mm | 6.8 mm (0.04 %) | 0.10° | 98.2 % | 98.5 % |

Map precision = share of occupied cells less than 10 cm from a real wall. Map coverage = share of the seen walls that are in the map.
