MikkelBlom/SENNEP-V2/print/testhjul_v3.1/spejlvendt/LÆS MIG.md

# Spejlvendte hjul (to af de fire hjørner)

Spejlvendte kopier (x → −x) af v3.1-filerne, vendt rigtigt til print som originalerne. Samme indstillinger som i `../LÆS MIG.md`.

| Fil | Antal | Hvorfor |
|---|---|---|
| 2x_RimA_motorside_SPEJLVENDT.stl | 2 | Pindene (rullevinklen) og de skrå riller er spejlet |
| 2x_RimB_outer_SPEJLVENDT.stl | 2 | Do. |
| 1x_Samlering_..._SPEJLVENDT.stl | 1 | Vuggerne følger rullernes vinkel. Vælg med/uden sleeves som før |

Uændret (bruges som de er): ruller, sleeves, aksel, **afstandsrør**, housing, lejeholder, krave.

**Afstandsrøret i en spejlvendt Rim A:** tryk det lige ind, og drej det 60° den **modsatte vej** af de normale hjul. Testet i Fusion: det går fri hele vejen, låser (kan ikke trækkes ud), og sekskanten flugter med akslen.
