MikkelBlom/SENNEP-V2/print/testhjul_v3.1/hjulkasse/samling_3_noegle_gennem_vinduer.png

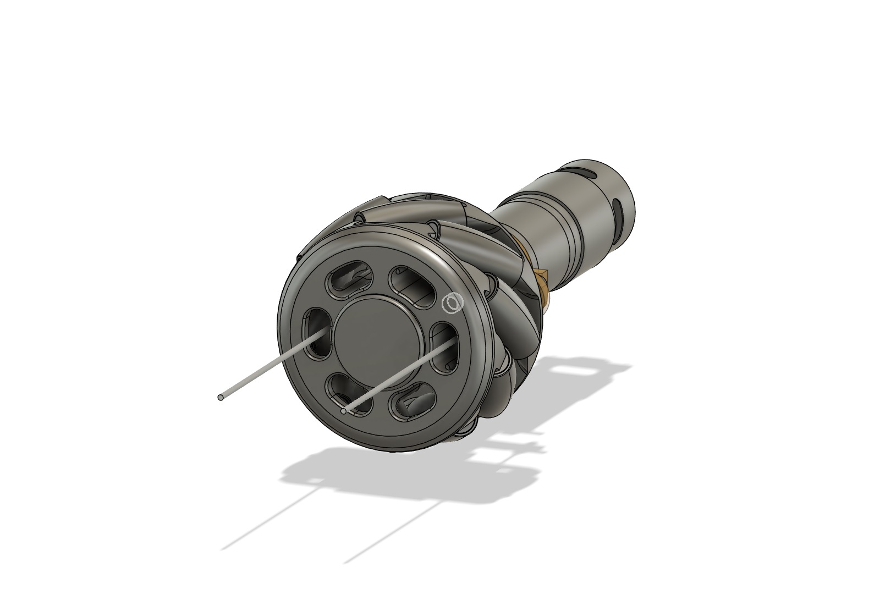
print/testhjul_v3.1/hjulkasse/samling_3_noegle_gennem_vinduer.png
