MikkelBlom/SENNEP-V2/print/testhjul_v3.1/samlering/samlering_med_rim_A.png

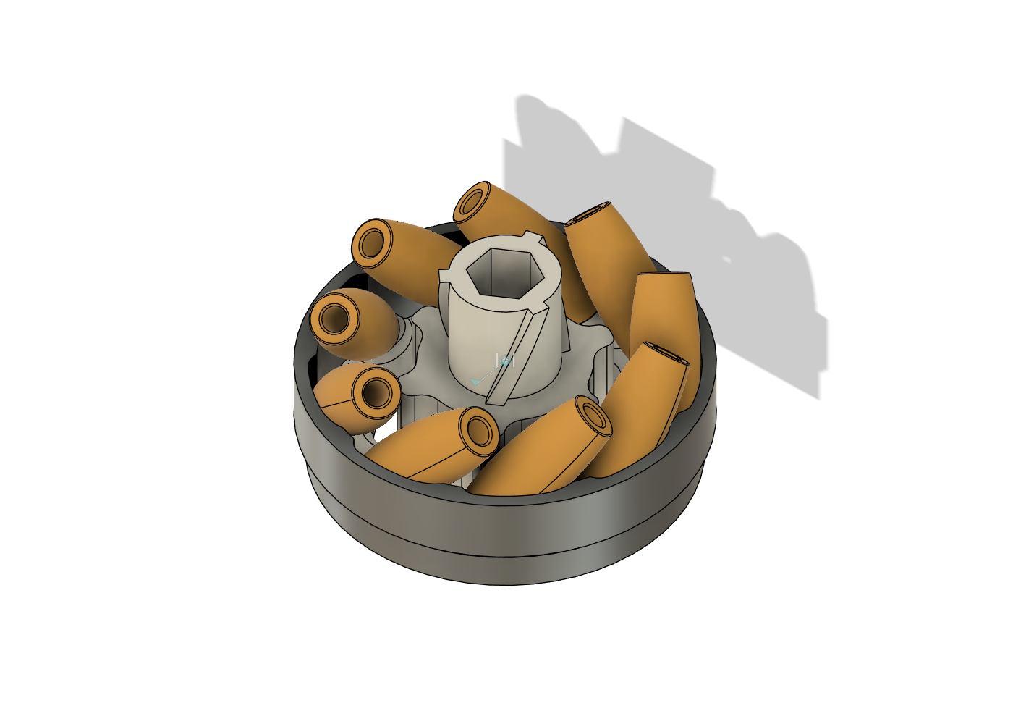
print/testhjul_v3.1/samlering/samlering_med_rim_A.png
