MikkelBlom/SENNEP-V2/lidar/src/lib.rs

//! SENNEP V2 LiDAR stack. See docs/lidar/PLAN.md for the why.

pub mod clock;
pub mod eval;
pub mod filter;
pub mod geom;
pub mod grid;
pub mod motion;
pub mod odom;
pub mod pipeline;
pub mod player;
pub mod protocol;
pub mod recording;
pub mod scan;
pub mod server;
pub mod sim;
pub mod source;
pub mod sys;
pub mod walls;
pub mod zones;
