MikkelBlom/SENNEP-V2/(commit log)

2026-10-12 Initial commit: SENNEP V2 omni-wheel robot
    Fusion generators for the wheel, housing and chassis, print files
    (wheel v3.1, assembly ring, housing v2), component inventory with
    datasheets, ESP-01 sketches, the old LiDAR test environment and the
    AI working notes. Invoices, order lists and chat exports stay local.
    [1x_Axle.stl, 1x_Bearing_keeper.stl, 1x_Housing.stl, 1x_Housing_hul_variant.stl, 1x_Motor_collar.stl, 1x_P-M8_moetrik.stl, 1x_P-M8x26_bolt.stl, 1x_Pod_hjulkasse.stl]
2026-10-12 Log blocked PCB session: breadboard plan missing
    Claude-Session: https://claude.ai/code/session_01PytR6jgVhcvKtwbwg2TuYA
2026-10-12 Batteriplan udkast v1: status, metoder rangeret, BMS-ledninger, matching
    Claude-Session: https://claude.ai/code/session_01EjR1nszMYWgJ4aE8CfYJBW
2026-10-12 PI_MEGA_LINK: round 1 answers, UART feasibility, latency chain, central vs distributed MCUs
    Claude-Session: https://claude.ai/code/session_01GANwTzJFtn3odfo3AV2xFc
2026-10-12 Batteriplan v2: svejseservice i Odense, målevejledning for celler, inventory-rettelser
    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
    [inventory.csv]
2026-10-12 PI_MEGA_LINK: round 2 approved, expansion plan, UART allocation
    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
2026-10-12 LiDAR v2: plan draft with stock-take, research, options and round 1 decisions
    Claude-Session: https://claude.ai/code/session_01FwfgtFk4u3Z1GfeuqGgczX
2026-10-12 Link protocol: spec + generator, portable C core (COBS/CRC + safety logic), Mega sketch, Python test peer, host tests
    Checkpoint before the Rust decision: the C core and tests validate the wire format and the approved safety rules.
    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
2026-10-12 LiDAR v2 plan: round 2 decisions (Rust, zones to Mega, USB) and final architecture
    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
2026-10-12 Elektronik: plan v0.2 efter Mikkels svar (M1-omfang, test-LiPo, min/anbefalet indkøb, testrækkefølge)
    Claude-Session: https://claude.ai/code/session_01Wqkj3YBWZP1iEmL1sxAzRq
2026-10-12 Restructure docs: project CLAUDE.md, AI notes, English docs/
    Split PROJECT_OVERVIEW into docs/ (requirements, wheel, chassis,
    motor-and-power, printing-lessons, fusion-scripting, history) and archive
    the original plus HANDOFF_CHASSIS unchanged. Add INDEX, FEATURES,
    WORKING_NOTES (open concerns + decisions) and FUTURE_IDEAS. Fold Cut
    noter.txt into docs/history.md. Ignore secrets.h.
    Claude-Session: https://claude.ai/code/session_01RvbhEyDbomfwyjXLW8o66k
2026-10-12 Translate parts list to English, add source and condition columns
    inventory.csv, build_inventory.py, the HTML template and README are now
    English. New columns: source (SENNEP V2 / SENNEP V1 / other project) and
    condition (ok / used / broken / unknown), validated by the build script and
    filterable in index.html. The always-empty order column is dropped (public
    repo). All 85 lines kept, Danish ids renamed.
    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
    [inventory.csv]
2026-10-12 Expand PCB session note with task scope for consolidation
    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
2026-10-12 Log docs session, defer physical parts count to consolidation
    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
    [inventory.csv]
2026-10-12 LiDAR v2 (Rust): parser, clock, scan assembly, filters, safety zones, odometry, grid, simulator + tests
    Recordings: whole revolutions, static pose jitter 0.2-0.7 mm. Sim tour 8.7 m:
    end drift 0.04 %, map precision ~99 %, zones never optimistic.
    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
    [clock.rs, filter.rs, geom.rs, grid.rs, lib.rs, odom.rs, pipeline.rs]
2026-10-12 LiDAR v2: web UI + WebSocket server, main binary (serial/replay/sim), CPU/RAM diagnostics
    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
2026-10-12 LiDAR v2: keyframe reuse (no drift on revisits), bench + BENCHMARK.md, aarch64 build, README, Pi service, notes
    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
    [eval.rs, lib.rs, main.rs, odom.rs, pipeline.rs, sim.rs]
2026-10-12 LiDAR v2: UI screenshot (7-inch layout, simulator)
    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
2026-10-12 LiDAR v2: full handoff note for consolidation session
    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
2026-10-12 Consolidate the 6 cloud sessions: English docs, reconciled plans, project hub
    - Translate battery, breadboard, Pi-Mega link and LiDAR docs (+ bench output) to English
    - Reconcile the breadboard plan with the approved link design (GPIO UART, ESP-01 dropped,
    LiDAR on USB, pin map from config.h; A4 bus sense and pin 29 arm button reserved)
    - Move other sessions' PROJECT_OVERVIEW notes out of the frozen archive into WORKING_NOTES/FEATURES
    - Inventory: counted column, 15 missing tools/leftovers, CP2102
    - Archive the session handoffs and DOCS_PLAN
    - New hub/: local HTML over CSV/Markdown files for tasks, parts, tools, shopping,
    battery cells, ideas, links and notes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
    [battery_cells.csv, ideas.csv, inventory.csv, links.csv, shopping.csv, tasks.csv]
2026-10-12 Record Q1: Arduino C++ + IDE on the Mega
    Claude-Session: https://claude.ai/code/session_016M81C7Q1Ez87pKSp6Uuete
    [tasks.csv]
2026-10-12 Hub: interactive battery diagram (top/bottom view, strip layer, click-to-log cells)
    Fixed orientation: black mark front-left; front row G1 (slots 1-6), middle G2 (7-12), back G3 (13-18).
    battery_cells.csv gets a slot column; first reading (cell 1, 3.535 V) logged.
    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
    [battery_cells.csv]
2026-10-12 Document the fixed battery orientation
    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
2026-10-12 Hub battery: see-through bottom view by default, coloured strips, series path
    The flipped bottom view put row 1 at the back, so strip D (rows 2+3) looked like it covered
    the same rows as strip A on top. Default bottom view now keeps every row in place; the flipped
    view is an option.
    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
2026-10-12 Added battery values
    [battery_cells.csv]
2026-10-12 Battery: all 20 cells measured and matched; next tasks
    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
    [battery_cells.csv, tasks.csv]
2026-10-12 Battery: strip types and orientation, collector current note, BMS listing data (HW-288)
    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
    [inventory.csv]
2026-10-12 Battery: measured holder pitch 20.2 mm vs 19 mm strip, how to handle it
    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
    [tasks.csv]
2026-10-12 Motor resistance measured (stall ~7-8 A), fuse rows cleaned up, drop BMS photo task
    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
    [inventory.csv, shopping.csv, tasks.csv]
2026-10-12 LiDAR: wall lines, objects and moving-thing tracking
    - walls.rs: wall segments fitted to the occupancy grid (not single scans), persistent ids,
    smoothed lines, immediate growth, sticky corner joins; leftover solid cells = objects
    - motion.rs: moving points = hits in known-free space away from anything solid; blobs;
    Kalman tracks with speed, 25 cm travel before shown, 2 s coasting when lost
    - moving points never become map hits; server frames 4 (walls/objects) and 5 (motion)
    - web UI in English with layer buttons, gliding wall ends, trails and 1 s prediction arrows
    - tests: Mikkel's room recording (one walker, no ghosts, stable walls) + simulator
    (no ghost movers while driving, simulate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
    [ideas.csv, tasks.csv]
2026-10-12 LiDAR: record from the page, agile tracking (sprints, bending down)
    - recording.rs: a live LiDAR records itself into recordings/auto/ (git-ignored, newest 20 kept,
    30 min files); the page can Keep (move under a name + notes), Mark a moment, Stop and Start
    - tracker: accel sigma 5 m/s^2, gate grows with speed, lost tracks slow down and stay within
    1 m for up to 3 s, a detection near a lost track takes over its id
    - room_2 recording (+ notes): one id through 3 sprints (~3.5 m/s) and bending down; new test
    - notes files for both recordings, recordings/README.md
    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
    [tasks.csv]
2026-10-12 LiDAR: playback in the page, glass and far-corner tracking fixes
    - player.rs + main loop: Recordings list, play/pause, +-5 s, jump to mm:ss, timeline with marks,
    speed 0.25-4x, back to live; --replay opens straight into playback
    - tracker: lost tracks remembered 10 s for re-acquire, confirmation needs >= 6 points on average,
    small blobs in spots that keep flickering (glass kettle) are ignored, blobs next to a tracked
    person belong to them; tracker.visible() for what is shown
    - room_3 recording (+ notes) and test: one id for the whole visit, the kettle never a mover
    Claude-Session: https://claude.ai/code/session_016M81C7Q1Ez87pKSp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
    [lib.rs, main.rs, motion.rs, player.rs, server.rs]
2026-10-12 LiDAR playback: full pipeline reset on play/switch/jump/live
    Every recording has its own timestamps; resetting only the map left the parser, sensor clock and
    scan assembly in the old time base, so after switching recordings or jumping no walls appeared or
    scans stopped until "New map". Pipeline::reset_all() now runs for every new byte stream; tests for
    jumping back and for switching recordings. room_3 notes completed with Mikkel's answers.
    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
    [main.rs, pipeline.rs, player.rs]
2026-10-12 Handoff for the next session; CLAUDE.md status brought up to date
    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
    [tasks.csv]
2026-10-13 Make chassis rails and cross members universal
    One rail part for all four places and one cross-member half for all
    crosses: centre joints now use a V-groove in both parts plus a loose
    printed key bar. Printed M8 bolts and nuts get a built-in flange, so no
    washers. Chassis rebuilt around housing v2; minimum print set exported.
    [20x_P-M8_nut.stl, 20x_P-M8x22_bolt.stl, 4x_Cross_half.stl, 4x_Key_bar.stl, 4x_Rail.stl]
2026-10-14 Add mirrored wheel parts for the other-handed corners
    Rim A, Rim B, the spacer and the assembly ring mirrored straight from the
    v3.1 print files. The spacer bayonet and the ring cradles are handed too.
    [1x_Samlering_med_TPU_sleeves_SPEJLVENDT.stl, 1x_Samlering_uden_sleeves_SPEJLVENDT.stl, 2x_RimA_motorside_SPEJLVENDT.stl, 2x_RimB_outer_SPEJLVENDT.stl, 2x_Spacer_SPEJLVENDT.stl]
2026-10-14 Drop the mirrored spacer: the original locks in a mirrored rim
    Checked in Fusion: it slides in straight and locks when twisted the
    other way, with the hex still aligned.
    [2x_Spacer_SPEJLVENDT.stl]
2026-10-15 Note the AlmaOS → Faber rename in the session log
    The side project's folder moved to ../Faber; the log entry now points there.
2026-10-17 Run the LiDAR stack on the Pi 5
    The Pi is set up (Raspberry Pi OS trixie, 4 GB) and runs sennep-lidar as a service. The unit gets
    its own state folder, since it couldn't write recordings in /. Pi benchmark added: about 4 % of one
    core.
2026-10-17 Log: Faber owns the LiDAR on the Pi, sennep-lidar disabled
2026-10-17 Log: SENNEP V2 as a Circuits drawing in Faber
2026-10-18 Status grilling: aluminium frame idea, battery route, prices, Faber apps
    Records Mikkel's answers from 2026-10-18: wheels and housings are printed and assembled, the frame may move to 2040/2020 profiles with M5 nyloc, the battery waits on the workshop's price (else a spot welder), the breadboard plan was never reviewed, and the LiDAR view and AI camera become Faber apps. Hub shopping gets today's AliExpress and Bambu prices.
    [shopping.csv, tasks.csv]
2026-11-06 Log disk cleanup session
    Removed the Next.js build cache in the LiDAR test environment; no stale worktrees existed.
